bvenneker/AtariXL/README.md

This Chat64 for Atari 800xl  (or 600xl with expanded memory)
