bvenneker/AtariXL/ESP32/800XL_Chat_3/800XL_Chat_3.ino

#include <Preferences.h>
#include <ArduinoJson.h>
#include "common.h"
#include "utils.h"
#include "wifi_core.h"
#include "prgfile.h"
Preferences settings;

// About the regID (registration id)
// A user needs to register at https://www.chat64.nl
// they will receive a registration_id via email.
// that number needs to be filled in on the account setup page on the Atari
// now the cartridge is registered and the administrator has a way to block the user
// the user can not register again with the same email address if they are blocked

// ********************************
// **     Global Variables       **
// ********************************
String urgentMessage = "";
int wificonnected = -1;
char regStatus = 'u';
volatile bool dataFromHost = false;
volatile bool io2 = false;
char inbuffer[250];  // a character buffer for incoming data
int inbuffersize = 0;
char outbuffer[250];  // a character buffer for outgoing data
int outbuffersize = 0;
char textsize = 0;
int it = 0;
int doReset = 0;
volatile byte ch = 0;
TaskHandle_t Task1;
byte send_error = 0;
int userpageCount = 0;
char multiMessageBufferPub[3500];
char multiMessageBufferPriv[3500];
unsigned long first_check = 0;
//int screenColor = 148;
unsigned long hangup =0;
int lastCommand =0;
WiFiCommandMessage commandMessage;
WiFiResponseMessage responseMessage;
bool waitAck = false;
int scrollBufferIndex = 0;
int publicBufferIndex = 0;
int privateBufferIndex =0;
int ackResult=0;
// ********************************
// **        OUTPUTS             **
// ********************************
// see http://www.bartvenneker.nl/index.php?art=0030
// for usable io pins!

#define CLED GPIO_NUM_5     // led on cartridge
#define sclk1 GPIO_NUM_27   // serial clock signal to the shift register
#define RCLK GPIO_NUM_14    // RCLK signal to the 165 shift register
#define sclk2 GPIO_NUM_25   // serial clock signal to the shift register
#define oSdata GPIO_NUM_33  // serial data to output buffer
#define RTR GPIO_NUM_32     // Ready to receive signal
#define RTS GPIO_NUM_4      // Ready to send signal


// ********************************
// **        INPUTS             **
// ********************************
#define resetSwitch GPIO_NUM_26
#define HostIO1 GPIO_NUM_22
#define sdata GPIO_NUM_34
#define HostIO2 GPIO_NUM_13

// *************************************************
// Interrupt routine for IO1
// *************************************************
void IRAM_ATTR isr_io1() {
  // This signal goes LOW when the Atari writes to the $D502 address.
  ready_to_receive(false);
  ch = 0;
  ch = shiftIn(sdata, sclk1, MSBFIRST);
  dataFromHost = true;
}

// *************************************************
// Interrupt routine for IO2
// *************************************************
void IRAM_ATTR isr_io2() {
  // This signal goes LOW when the Atari reads from address $D502
  io2 = true;
}

// *************************************************
// Interrupt routine, to restart the esp32
// *************************************************
void IRAM_ATTR isr_reset() {
  reboot();
}

void resetComputer() {
  // reset the computer.
  // on Atari, there is no reset pin to pull down on the cartridge port
  // instead we try a jump to the start OS vector in $E477
  sendByte(232);
}

void reboot() {
  resetComputer();
  ESP.restart();
}

void create_Task_WifiCore() {
  // we create a task for the second (unused) core of the esp32
  // this task will communicate with the web site while the other core
  // is busy talking to the Host
  xTaskCreatePinnedToCore(
    WifiCoreLoop, /* Function to implement the task */
    "Task1",      /* Name of the task */
    10000,        /* Stack size in words */
    NULL,         /* Task input parameter */
    0,            /* Priority of the task */
    &Task1,       /* Task handle. */
    0);           /* Core where the task should run */
}
// *************************************************
//  SETUP
// *************************************************
void setup() {
    // define inputs
  pinMode(sdata, INPUT);
  pinMode(HostIO1, INPUT_PULLUP);
  pinMode(HostIO2, INPUT_PULLUP);
  pinMode(resetSwitch, INPUT_PULLUP);

  // define interrupts
  attachInterrupt(HostIO1, isr_io1, FALLING);         // interrupt for io1, Atari writes data at $D502
  attachInterrupt(HostIO2, isr_io2, FALLING);         // interrupt for io2, Atari reads data at $D502
  attachInterrupt(resetSwitch, isr_reset, FALLING);  // interrupt for reset button


  // define outputs
  pinMode(RTR, OUTPUT);
  digitalWrite(RTR, LOW);
  pinMode(RTS, OUTPUT);
  digitalWrite(RTS, LOW);

  pinMode(oSdata, OUTPUT);
  pinMode(CLED, OUTPUT);
  digitalWrite(CLED, LOW);
  ready_to_receive(false);
  ready_to_send(false);
  pinMode(RCLK, OUTPUT);
  digitalWrite(RCLK, LOW);  // must be low
  pinMode(sclk1, OUTPUT);
  digitalWrite(sclk1, LOW);  // data shifts to serial data output on the transition from low to high.
  pinMode(sclk2, OUTPUT);
  digitalWrite(sclk2, LOW);  // data shifts to serial data output on the transition from low to high.


  Serial.begin(115200);

  commandBuffer = xMessageBufferCreate(sizeof(commandMessage) + sizeof(size_t));
  responseBuffer = xMessageBufferCreate(sizeof(responseMessage) + sizeof(size_t));

  create_Task_WifiCore();

  // get the wifi mac address, this is used to identify the cartridge.
  commandMessage.command = GetWiFiMacAddressCommand;
  xMessageBufferSend(commandBuffer, &commandMessage, sizeof(commandMessage), portMAX_DELAY);
  xMessageBufferReceive(responseBuffer, &responseMessage, sizeof(responseMessage), portMAX_DELAY);
  macaddress = responseMessage.response.str;
  macaddress.replace(":", "");
  macaddress.toLowerCase();
  macaddress = macaddress.substring(4);

  // add a checksum to the mac address.
  byte data[4];
  int i = 0;
  for (unsigned int t = 0; t < macaddress.length(); t = t + 2) {
    String p = macaddress.substring(t, t + 2);
    char n[3];
    p.toCharArray(n, 3);
    byte f = x2i(n);
    data[i++] = f;
  }
  String crc8 = String(checksum(data, 4), HEX);

  if (crc8.length() == 1) crc8 = "0" + crc8;
  macaddress += crc8;

  // init settings object to store settings in the eeprom
  settings.begin("mysettings", false);
  //
  doReset = settings.getInt("doReset", 0);
  // get the configured status from the eeprom
  configured = settings.getString("configured", "empty");

  // get the registration id from the eeprom
  regID = settings.getString("regID", "unregistered!");

  // get the nick name from the eeprom
  myNickName = settings.getString("myNickName", "empty");

  // get the last known message id (only the private is stored in eeprom)
  lastprivmsg = settings.getULong("lastprivmsg", 1);

  // get Chatserver ip/fqdn from eeprom
  server = settings.getString("server", "www.chat64.nl");
  if (server=="empty") server="www.chat64.nl";
  
  ssid = settings.getString("ssid", "empty");  // get WiFi credentials and Chatserver ip/fqdn from eeprom
  password = settings.getString("password", "empty");
  timeoffset = settings.getString("timeoffset", "+0");  // get the time offset from the eeprom

  screenColor = settings.getUInt("scrcolor", 148);
   
  settings.end();


  //ready_to_receive(false);
  if (doReset != 157) {
    resetComputer();

  } else {
    settings.begin("mysettings", false);
    settings.putInt("doReset", 0);
    messageIds[0] = settings.getULong("lastPubMessage", 0);
    messageIds[1] = settings.getULong("lastPrivMessage", 0);
    settings.end();
    pastMatrix = true;
    hangup=millis();
  }
  settings.begin("mysettings", false);
  settings.putInt("doReset", 0);
  settings.end();




  // load the prg file
  if (!pastMatrix) loadPrgfile();

  // start wifi
  commandMessage.command = WiFiBeginCommand;
  xMessageBufferSend(commandBuffer, &commandMessage, sizeof(commandMessage), portMAX_DELAY);

  //commandMessage.command = GetWiFiLocalIpCommand;
  //xMessageBufferSend(commandBuffer, &commandMessage, sizeof(commandMessage), portMAX_DELAY);
  //xMessageBufferReceive(responseBuffer, &responseMessage, sizeof(responseMessage), portMAX_DELAY);
  //String localIp = responseMessage.response.str;
  // check if we are connected to wifi
  if (isWifiCoreConnected) {
    wificonnected = 1;
  }
  pmCount=0;
}  // end of setup

// ******************************************************************************
// Main loop
// ******************************************************************************
int pos1 = 0;
int pos0 = 0;
bool wifiError = false;
void loop() {


  digitalWrite(CLED, isWifiCoreConnected);
  ready_to_receive(true);

  if (isWifiCoreConnected and wificonnected == -1) wificonnected = 1;  // only set wificonnected if it has not been set

  if (dataFromHost) {
    dataFromHost = false;
    ready_to_receive(false);  // flow controll
    lastCommand=ch;
#ifdef debug
    //Serial.printf("incoming command: %d\n", lastCommand);
#endif

    //
    if (wifiError and isWifiCoreConnected) {
      urgentMessage = "Wifi connection restored.       ";
      wifiError = false;
      wificonnected = 1;
    }

    // generate an error if wifi connection drops
    if (wificonnected == 1 && !isWifiCoreConnected) {
      digitalWrite(CLED, LOW);
      wificonnected = 0;
      myLocalIp = "0.0.0.0";
      urgentMessage = "Error in WiFi connection.       ";
      wifiError = true;
    }

    // 254 = Computer triggers call to the website for new public message
    // 253 = New chat message from Computer to database
    // 252 = Computer sends the new wifi network name (ssid) AND password AND time offset
    // 251 = Computer ask for the current wifi ssid,password and time offset
    // 250 = Computer ask for the first full page of messages (during startup)
    // 249 = get result of last send action (253)
    // 248 = Computer ask for the wifi connection status
    // 247 = Computer triggers call to the website for new private message
    // 246 = set chatserver ip/fqdn
    // 245 = check if the esp is connected at all, or are we running in simulation mode?
    // 244 = reset to factory defaults
    // 243 = Computer ask for the mac address, registration id, nickname and regstatus
    // 242 = get senders nickname of last private message.
    // 241 = get the number of unread private messages
    // 240 = Computer sends the new registration id and nickname to ESP32
    // 239 = Computer asks if updated firmware is available
    // 238 = Computer triggers call to the chatserver to test connectivity
    // 237 = get chatserver connectivity status
    // 236 = Computer asks for the server configuration status and servername
    // 235 = Computer sends server configuration status
    // 234 = get user list first page
    // 233 = get user list next page
    // 232 = Restart the computer (Atari only)
    // 231 = Do the update
    // 230 = Computer sends screen color (Atari Only)
    // 228 = NACK, Not Acknowledge message!
    // 227 = ACK, Acknowledge message!
    // 128 = end marker, ignore

    switch (ch) {
      case 254:
        {
          hangup = millis();
          // ------------------------------------------------------------------------------
          // start byte 254 = Computer triggers call to the website for new public message
          // ------------------------------------------------------------------------------
          if (first_check == 0) first_check = millis();
          pastMatrix=true;
          // send urgent messages first
          doUrgentMessage();
          // if the user list is empty, get the list
          // also refresh the userlist when we switch from public to private messaging and vice versa
          if (onLineUsers.length() < 1 or msgtype != "public") updateUserlist = true;
          msgtype = "public";
          if (getMessageFromMMBuffer(multiMessageBufferPub, &publicBufferIndex, false)) {
            if (Deserialize() == 1) {              
              // deserialize returns 1 of there was a message in the buffer (2 for private message).
              translateAtariMessage();
              //prependChecksum(outbuffer, &outbuffersize); // add a checksum to the end of the buffer
              send_buffer_to_host(outbuffer, outbuffersize);  // send it
              messageIds[0] = tempMessageIds[0];             // store the new message id;
            } else sendByte(128);                            // no more messages for now.              
          } else {
            sendByte(128);  // no more messages for now.
            getMessage = true;
          }
          break;
        }

      case 253:
        {
          // ------------------------------------------------------------------------------
          // start byte 253 = new chat message from Computer to database
          // ------------------------------------------------------------------------------
          // we expect a chat message from the Computer
          
          receive_buffer_from_host(1,true);

          String toEncode = "[145]";
          String RecipientName = "";
          int pmuserlen=0;          
          int mstart = 0;

          // Get the RecipientName
          // see if the message starts with '@'
          byte b = inbuffer[0];
          if (b == '@') {
            for (int x = 1; x < 15; x++) {
              byte b = inbuffer[x];
              if (b != ' ' and b != ',' and b != ':' and b != ';' and b != '.') {
                if (b < 127) {
                  RecipientName = (RecipientName + char(b));
                }
              } else {
                mstart = x + 1;
                toEncode = toEncode + "@" + RecipientName + " ";
                break;
              }
            }
          }

          for (int x = mstart; x < inbuffersize - 1; x++) {
            byte b = inbuffer[x];
            toEncode = (toEncode + inbuffer[x]);
          }

          if (RecipientName != "") {
            // is this a valid username?
            String test_name = RecipientName;
            if (test_name.endsWith(",") or test_name.endsWith(".")) {
              test_name.remove(test_name.length() - 1);
            }
            test_name.toLowerCase();
#ifdef debug
            Serial.print("known users: ");
            Serial.println(users);
            Serial.print("Name under test: ");
            Serial.println(test_name);
#endif
            if ((offLineUsers.indexOf(test_name + ';') >= 0) or (onLineUsers.indexOf(test_name + ';') >= 0)) {
              // user exists
              msgtype = "private";
              pmSender = '@' + RecipientName;
            } else {
              // user does not exist
#ifdef debug
              Serial.println("Username not found in list");
#endif
              urgentMessage = "Error: Unknown user:" + RecipientName;
              send_error = 1;
              break;
            }
          } else {
            msgtype = "public";
          }
          toEncode.trim();

          int buflen = toEncode.length() + 1;
          if (buflen -mstart <= 7) break;                  // this is an empty message! do not send it.
          char buff[buflen];
          toEncode.toCharArray(buff, buflen);
          String Encoded = my_base64_encode(buff, buflen);
          Encoded = urlEncode(Encoded);
          // Now send it with retry!
          bool sc = false;
          int retry = 0;
          while (sc == false and retry < 2) {
            sendingMessage = 1;
            commandMessage.command = SendMessageToServerCommand;
            Encoded.toCharArray(commandMessage.data.sendMessageToServer.encoded, sizeof(commandMessage.data.sendMessageToServer.encoded));
            RecipientName.toCharArray(commandMessage.data.sendMessageToServer.recipientName, sizeof(commandMessage.data.sendMessageToServer.recipientName));
            commandMessage.data.sendMessageToServer.retryCount = retry;
            xMessageBufferSend(commandBuffer, &commandMessage, sizeof(commandMessage), portMAX_DELAY);
            xMessageBufferReceive(responseBuffer, &responseMessage, sizeof(responseMessage), portMAX_DELAY);
            sc = responseMessage.response.boolean;
            // sending the message fails, take a short break and try again
            if (!sc) {
              delay(1000);
              retry = retry + 1;
            }
          }
          // if it still fails after a few retries, give us an error.
          if (!sc) {
            urgentMessage = ">>ERROR: sending the message<<";
            send_error = 1;
            sendingMessage = 0;
          } else {
            // No error, read the message back from the database to show it on screen
            sendingMessage = 0;
            getMessage = true;  // get the message we just inserted
          }
          break;
        }

      case 252:
        {
          // ------------------------------------------------------------------------------
          // 252 = Computer sends the new wifi network name (ssid) AND password AND time offset
          // ------------------------------------------------------------------------------

          receive_buffer_from_host(3,true);
          // inbuffer now contains "SSID password timeoffset"
          char bns[inbuffersize + 1];
          strncpy(bns, inbuffer, inbuffersize + 1);
          String ns = bns;

          ssid = getValue(ns, 129, 0);
          ssid = ssid.substring(0,27);
          
          ssid.trim();
          Serial.print("SSID=");
          Serial.println(ssid);
          password = getValue(ns, 129, 1);
          password=password.substring(0,23);
          password.trim();
          Serial.print("PASW=");
          Serial.println(password);
          timeoffset = getValue(ns, 129, 2);
          timeoffset = timeoffset.substring(0,5);
          timeoffset.trim();
          Serial.print("GMT+=");
          Serial.println(timeoffset);

          settings.begin("mysettings", false);
          settings.putString("ssid", ssid);
          settings.putString("password", password);
          settings.putString("timeoffset", timeoffset);
          settings.end();
          softReset();
          break;
        }

      case 251:
        {
          // ------------------------------------------------------------------------------
          // start byte 251 = Computer ask for the current wifi ssid,password and time offset
          // ------------------------------------------------------------------------------
          send_String_to_host(ssid + char(129) + password + char(129) + timeoffset);
          break;
        }

      case 249:
        {
          // ------------------------------------------------------------------------------
          // start byte 249 = Computer asks if this is an existing user (for private chat)
          // ------------------------------------------------------------------------------
          sendByte(send_error);
          sendByte(128);
          send_error = 0;
          break;
        }

      case 248:
        {
          // ------------------------------------------------------------------------------
          // start byte 248 = Computer ask for the wifi connection status
          // ------------------------------------------------------------------------------

          if (!isWifiCoreConnected) {
            digitalWrite(CLED, LOW);
            send_String_to_host("0    Not Connected to Wifi         ");
          } else {
            wificonnected = 1;
            digitalWrite(CLED, HIGH);
            String wifi_status = "1Connected, ip: " + myLocalIp + "             ";
            wifi_status = wifi_status.substring(0, 35);
            send_String_to_host(wifi_status);
            if (configured == "empty") {
              configured = "w";
              settings.begin("mysettings", false);
              settings.putString("configured", "w");
              settings.end();
            }
          }
          break;
        }

      case 247:
        {
          hangup = millis();
          // ------------------------------------------------------------------------------
          // start byte 247 = Computer triggers call to the website for new private message
          // ------------------------------------------------------------------------------
          // send urgent messages first
          doUrgentMessage();
          // if the user list is empty, get the list
          // also refresh the userlist when we switch from public to private messaging and vice versa
          if (onLineUsers.length() < 1 or msgtype != "private") updateUserlist = true;
          msgtype = "private";
          if (getMessageFromMMBuffer(multiMessageBufferPriv, &privateBufferIndex, false)) {
            if (Deserialize() == 2) {              
              // deserialize returns 2 of there was a message in the buffer (1 for public message).
              translateAtariMessage();
              send_buffer_to_host(outbuffer, outbuffersize);  // send it
              messageIds[1] = tempMessageIds[1];             // store the new message id;
              lastprivmsg = messageIds[1];
              settings.begin("mysettings", false);
              settings.putULong("lastprivmsg", messageIds[1]);  // store message id in eeprom
              settings.end();
            } else sendByte(128);                            // no more messages for now.              
          } else {
            sendByte(128);  // no more messages for now.
            getMessage = true;
          }
          break;
        }

      case 246:
        {
          // ------------------------------------------------------------------------------
          // start byte 246 = Computer sends a new chat server ip/fqdn
          // ------------------------------------------------------------------------------

          receive_buffer_from_host(1,true);

          char bns[inbuffersize + 1];
          strncpy(bns, inbuffer, inbuffersize + 1);
          String ns = bns;

          ns.remove(ns.length() - 1);
          ns.trim();
          server = ns;
          settings.begin("mysettings", false);
          settings.putString("server", ns);  // store the new server name in the eeprom settings
          settings.end();
          messageIds[0] = 0;
          messageIds[1] = 0;

          // we should also refresh the userlist
          onLineUsers = "";
          break;
        }
      case 245:
        {
          // -----------------------------------------------------------------------------------------------------
          // start byte 245 = Computer checks if the Cartridge is connected at all.. or are we running in a simulator?
          // -----------------------------------------------------------------------------------------------------
          // receive the ROM version number

          receive_buffer_from_host(1,true);
          char bns[inbuffersize + 1];
          // filter out any unwanted bytes, keep only ./01234567890
          for (int k = 0; k < inbuffersize; k++) {
            inbuffer[k] = inbuffer[k] - 32;  // translate to atari screen coding
            if (inbuffer[k] < 45 or inbuffer[k] > 57) inbuffer[k] = 32;
          }
          strncpy(bns, inbuffer, inbuffersize + 1);
          String ns = bns;
          ns.replace(" ", "");
          romVersion = ns;
          // respond with byte 128 to tell the computer the cartridge is present
          sendByte(128);
          pastMatrix = true;
          getMessage = true;
#ifdef debug
          Serial.print("ROM Version=");
          Serial.println(romVersion);
          Serial.println("are we in the Matrix?");
#endif
          break;
        }
      case 244:
        {
          // ---------------------------------------------------------------------------------
          // start byte 244 = Computer sends the command to reset the cartridge to factory defaults
          // ---------------------------------------------------------------------------------
          // this will reset all settings

          receive_buffer_from_host(1,true);
          char bns[inbuffersize + 1];
          strncpy(bns, inbuffer, inbuffersize + 1);
          String ns = bns;
          if (ns.startsWith("RESET!")) {
            settings.begin("mysettings", false);
            settings.putString("regID", "unregistered!");
            settings.putString("myNickName", "empty");
            settings.putString("ssid", "empty");
            settings.putString("password", "empty");
            settings.putString("server", "www.chat64.nl");
            settings.putString("configured", "empty");
            settings.putString("timeoffset", "+0");
            settings.putUInt("scrcolor", 148);
            settings.end();
            // now reset the esp
            reboot();
          }
          break;
        }

      case 243:
        {
          // ------------------------------------------------------------------------------
          // start byte 243 = Computer ask for the mac address, registration id, nickname and regstatus
          // ------------------------------------------------------------------------------
          commandMessage.command = GetRegistrationStatusCommand;
          xMessageBufferSend(commandBuffer, &commandMessage, sizeof(commandMessage), portMAX_DELAY);
          xMessageBufferReceive(responseBuffer, &responseMessage, sizeof(responseMessage), portMAX_DELAY);
          regStatus = responseMessage.response.str[0];

          send_String_to_host(macaddress + char(129) + regID + char(129) + myNickName + char(129) + regStatus + char(128));
          if (regStatus == 'r' and configured == "w") {
            configured = "d";
            settings.begin("mysettings", false);
            settings.putString("configured", "d");
            settings.end();
          }
          break;
        }
      case 242:
        {
          // ------------------------------------------------------------------------------
          // start byte 242 = Computer ask for the sender of the last private message
          // ------------------------------------------------------------------------------
          send_String_to_host(pmSender);
          break;
        }
      case 241:
        {
          // ------------------------------------------------------------------------------
          // start byte 241 = Computer asks for the number of unread private messages
          // ------------------------------------------------------------------------------
          if (pmCount > 10) pmCount = 10;
          String pm = String(pmCount);
          if (pmCount < 10) { pm = "0" + pm; }
          pm = "[PM:" + pm + "]";
          if (pmCount == 0) pm = "--";
          //Serial.println(pm);
          send_String_to_host(pm);  // then send the number of messages as a string
          break;
        }
      case 240:
        {
          // ------------------------------------------------------------------------------
          // start byte 240 = Computer sends the new registration id and nickname to ESP32
          // ------------------------------------------------------------------------------
          receive_buffer_from_host(2,true);
          // inbuffer now contains "registrationid nickname"
          char bns[inbuffersize + 1];
          strncpy(bns, inbuffer, inbuffersize + 1);
          String ns = bns;

          regID = getValue(ns, 129, 0);
          regID=regID.substring(0,16);
          regID.trim();
          
#ifdef debug
          Serial.println(regID);
#endif
          if (regID.length() != 16) {
#ifdef debug
            Serial.println("Registration code length should be 16");
#endif
            break;
          }
          myNickName = getValue(ns, 129, 1);
          myNickName = myNickName.substring(0,10);
          myNickName.trim();
          myNickName.replace(' ', '_');
#ifdef debug
          Serial.println(myNickName);
#endif

          settings.begin("mysettings", false);
          settings.putString("regID", regID);
          settings.putString("myNickName", myNickName);
          settings.end();
          break;
        }
      case 239:
        {
          // ------------------------------------------------------------------------------
          // start byte 239 = Computer asks if updated firmware is available
          // ------------------------------------------------------------------------------                  
          send_String_to_host(newVersions);
          if (newVersions != "") urgentMessage = "New version available, press [ESC]";
          break;
        }
      case 238:
        {
          // ------------------------------------------------------------------------------
          // start byte 238 = Computer triggers call to the chatserver to test connectivity
          // ------------------------------------------------------------------------------
          ServerConnectResult = "Connection: Unknown, try again";
          commandMessage.command = ConnectivityCheckCommand;
          xMessageBufferSend(commandBuffer, &commandMessage, sizeof(commandMessage), portMAX_DELAY);          
          break;
        }
      case 237:
        {
          // ------------------------------------------------------------------------------
          // start byte 237 = Computer triggers call to receive connection status
          // ------------------------------------------------------------------------------
          send_String_to_host(ServerConnectResult);
          break;
        }
      case 236:
        {
          // ------------------------------------------------------------------------------
          // start byte 236 = Computer asks for the server configuration status and servername
          // ------------------------------------------------------------------------------
#ifdef debug
          Serial.println("response 236 = " + configured + " " + server + " " + SwVersion);
#endif
          send_String_to_host(configured + char(129) + server + char(129) + SwVersion + char(129));
          break;
        }
      case 235:
        {
          // ------------------------------------------------------------------------------
          // start byte 235 = Computer sends configuration status
          // ------------------------------------------------------------------------------
          receive_buffer_from_host(1,true);
          char bns[inbuffersize + 1];
          strncpy(bns, inbuffer, inbuffersize + 1);
          String ns = bns;
          configured = ns;
          settings.begin("mysettings", false);
          settings.putString("configured", ns);
          settings.end();
          break;
        }
      case 234:
        {
          // Computer asks for user list, first group.
          // we send a max of 20 users in one long string
          userpageCount = 0;
          String ul1 = userPages[userpageCount];
          send_String_to_host(ul1);
          userpageCount++;
          break;
        }
      case 233:
        {
          // Computer asks for user list, second or third group.
          // we send a max of 20 users in one long string
          String ul1 = userPages[userpageCount];
          send_String_to_host(ul1);
          userpageCount++;
          break;
        }
      case 232:
        {
          Serial.println("RESET button on Atari pressed");
          ESP.restart();
          break;
        }
      case 231:
        {  // do the update!
          receive_buffer_from_host(1,true);
          char bns[inbuffersize + 1];
          strncpy(bns, inbuffer, inbuffersize + 1);
          String ns = bns;          
          if (ns.startsWith("UPDATE!")) {
            Serial.println("Update = GO <<<<");
            outByte(2);
            detachInterrupt(HostIO1);  // disable IO1 and IO2 interrupts
            detachInterrupt(HostIO2);  // disable IO1 and IO2 interrupts
            commandMessage.command = DoUpdateCommand;
            xMessageBufferSend(commandBuffer, &commandMessage, sizeof(commandMessage), portMAX_DELAY);
          }
          break;
        }
      case 230:
        {
          dataFromHost=false;
          ready_to_receive(true);          
          while (dataFromHost == false) {
            delayMicroseconds(2);
          }
          ready_to_receive(false);
          screenColor = ch;
          dataFromHost=false;
          settings.begin("mysettings", false);
          settings.putUInt("scrcolor", screenColor);
          settings.end();
          break;
        }
      case 229:
        {
          // ------------------------------------------------------------------------------
          // start byte 229 = Scroll Up or Down
          // ------------------------------------------------------------------------------
          static String decoded_message;
          receive_buffer_from_host(1,false);
          if (inbuffer[0] == 0) topMes = 0;
          Serial.print("topMes=");
          Serial.println(topMes);
          systemLineCount = inbuffer[1];
          Serial.print("systemLineCount=");
          Serial.println(systemLineCount);
          pageSize = inbuffer[2];
          scrollDirection = inbuffer[3];  // 1 = up, 0 = down
          Serial.println("Scrolling starts");
          if (waitAck) {
            // if waitAck is true we repeat the message
            Serial.println("Waiting for ACK, resending last message");
            send_String_to_host(decoded_message);
            break;
          }
          
          if (scrollBufferIndex == 0) {  // send a message to the other core to collect older messages            
            gotScrollMessage = 0;
            commandMessage.command = ScrollUpDown;
            xMessageBufferSend(commandBuffer, &commandMessage, sizeof(commandMessage), portMAX_DELAY);
            while (gotScrollMessage == 0) delay(10);  // wait for that procedure to complete
          }
          // (more) data is in multiMessageBufferPub, collect a single message from the MMB
          if (getMessageFromMMBuffer(multiMessageBufferPub, &scrollBufferIndex, false)) {            
            if (Deserialize() == 3) {  // decoded message is in the msgbuffer now
              if (scrollDirection == 1) topMes = tempMessageIds[2];              
              if (scrollDirection == 0) botMes = tempMessageIds[2];
              Serial.print("topMes(2)=");
              Serial.println(topMes);
              Serial.println("Wait for ACK now");
              waitAck = true;
              // message is in the msgbuffer now.
              // invert the first 40 chars.
              for (int i=1;i<41;i++){
                 msgbuffer[i]=msgbuffer[i]+128;
              }
              //msgbuffer[msgbuffersize-1]=128;
              decoded_message = String(msgbuffer, msgbuffersize-1);
              //Serial.println((int)decoded_message[msgbuffersize-2]);
              //Serial.println((int)decoded_message[msgbuffersize-1]);
              Serial.print("lines=");
              Serial.println((int)decoded_message[0]);
              Serial.println(decoded_message);
              send_String_to_host(decoded_message);
              //send_buffer_to_host(msgbuffer, msgbuffersize);  // send it
              if (scrollDirection == 1 and topMes != 0) botMes = 0;
              break;
            }
          }
          sendByte(128);
          waitAck = false;
          break;
        } 
      case 228:
        { // NACK, negative acknowlegde. Something went wrong, the Computer needs the same message again.
          waitAck = false;
          ackResult=0;
          Serial.println("NOT ACK!");
          break; 
        }   
      case 227:
        { // ACK, message was received without error. Computer is ready for the next message.
          waitAck = false;
          ackResult=1;
          Serial.println("ACK!");
          break; 
        }  
      default:
        {
          sendByte(128);
          break;
        }
    }  // end of case statements


  }  // end of "if (dataFromHost)"
  else {
    if ((lastCommand==247 or lastCommand==254 or lastCommand==239 or lastCommand==241) and (millis() - hangup) > 2000){
       hangup=millis();
       sendByte(128);
       Serial.print("Prevented hangup with command: ");
       Serial.println(lastCommand);
    }
    // No data from host
  }
}  // end of main loop


// ******************************************************************************
// void to set a byte in the 74ls595 shift register
// ******************************************************************************
void outByte(byte c) {
  digitalWrite(RCLK, LOW);
  shiftOut(oSdata, sclk2, MSBFIRST, c);
  digitalWrite(RCLK, HIGH);
}

// ******************************************************************************
// void: send a string to the Computer
// ******************************************************************************
void send_String_to_host(String s) {
  outbuffersize = s.length() + 1;              // set outbuffer size
  s.toCharArray(outbuffer, outbuffersize);     // place the ssid in the output buffer
  send_buffer_to_host(outbuffer,outbuffersize); // and send the buffer
}

// ******************************************************************************
// Send the content of the outbuffer to the host
// ******************************************************************************
void send_buffer_to_host(char *buffer, int buffSize) {
  int lastbyte;
  // send the content of a buffer to the Atari
  for (int x = 0; x < buffSize - 1; x++) {
    delayMicroseconds(500);
    sendByte(buffer[x]);
    lastbyte = outbuffer[x];
  }
  if (lastbyte != 128) {  // all done, send end byte if not send yet
    delayMicroseconds(500);
    sendByte(128);
  }
}

// ******************************************************************************
// void: for debugging
// ******************************************************************************
void debug_print_inbuffer() {
  for (int x = 0; x < inbuffersize; x++) {
    char sw = screenCode_to_Ascii(inbuffer[x]);
    Serial.print(sw);
  }
}

// ******************************************************************************
//  void to receive characters from the host and store them in a buffer
// ******************************************************************************
void receive_buffer_from_host(int cnt,bool translate) {

  // cnt is the number of transmissions we put into this buffer
  // This number is 1 most of the time
  // but in the configuration screens the Computer will send multiple items at once (like ssid and password)

  int i = 0;
  while (cnt > 0) {
    ready_to_receive(true);  // ready for next byte
    unsigned long timeOut = millis() + 50;

    while (dataFromHost == false) {
      delayMicroseconds(2);  // wait for next byte
      if (millis() > timeOut) {
        ch = 128;
        dataFromHost = true;
#ifdef debug
        Serial.println("Timeout in receive buffer");
#endif
      }
    }
    ready_to_receive(false);
    dataFromHost = false;
    if (translate) 
      inbuffer[i] = Atari_to_Ascii(ch);
    else
      inbuffer[i] = ch;

    //Serial.print(inbuffer[i]);
    i++;
    if (i > 248) {  //this should never happen
#ifdef debug
      Serial.println("Error: inbuffer is about to flow over!");
#endif
      ch = 128;
      cnt = 1;
      break;
    }
    if (ch == 128) {
      cnt--;
      inbuffer[i] = 129;
      i++;
      //Serial.println();
    }
  }
  i--;
  inbuffer[i] = 0;  // close the buffer
  inbuffersize = i;
}

// ******************************************************************************
// send a single byte to the Host
// ******************************************************************************
bool sendByte(byte b) {
  bool result=true;

  outByte(b);
  io2 = false;
  ready_to_send(true);
  // wait for io2 interupt
  unsigned long timeOut = millis() + 300;
  while (io2 == false) {
    delayMicroseconds(2);
    if (millis() > timeOut) {
      io2 = true;
      Serial.print("Timeout in sendByte: ");
      Serial.println(b);
      result=false;
    }
  }
  ready_to_send(false);
  io2 = false;
  return result;
}

// ******************************************************************************
// Send out urgent message if available (error messages)
// ******************************************************************************
void doUrgentMessage() {
  int color = 2;
  if (urgentMessage != "") {
    urgentMessage = " " + urgentMessage;

    outbuffersize = urgentMessage.length() + 1;
    urgentMessage.toCharArray(outbuffer, outbuffersize);
    outbuffer[0] = 1;

    for (int x = 1; x < outbuffersize; x++) {
      int b = outbuffer[x] + 128;  // add 128 to inverse the text
      if (b < 97) b = b - 32;
      if (b >= 160 and b < 192) b = b - 32;
      else if (b > 191 and b < 225) b = b - 32;
      if (b == 128) b = 254;
      outbuffer[x] = b;
    }

    send_buffer_to_host(outbuffer,outbuffersize);
    urgentMessage = "";
  }
}

void translateAtariMessage() {
  // do some translations for Atari 800 XL
  // first byte is number of lines.
  // for the atari we start with a number of 'shift up commands' 
  int sp = msgbuffer[0];
  outbuffersize = 0;
  for (int a = 0; a < sp; a++) {
    outbuffer[a] = 1;  // 1 means shift up one line.  1,1,1 means shift up 3 lines
  }
  outbuffersize = sp;
  // now convert to internal codes (screen codes)
  for (int x = 1; x < msgbuffersize; x++) {
    int b = msgbuffer[x];
    if (b < 97) b = b - 32;
    if (b >= 160 and b < 192) b = b - 32;
    else if (b > 191 and b < 225) b = b - 32;
    if (b == 128) b = 254;
    outbuffer[outbuffersize] = b;
    outbuffersize++;
  }
}

void ready_to_receive(bool b) {  
  if (b) {
    digitalWrite(RTR, HIGH);    
  }
  else {
    digitalWrite(RTR, LOW);
  }
  return;
}

void ready_to_send(bool b) {
  if (b){
    digitalWrite(RTS, HIGH);
  }
  else {
    digitalWrite(RTS, LOW);
  }
  return;
}

uint8_t myShiftIn(uint8_t dataPin, uint8_t clockPin, uint8_t bitOrder) {
  uint8_t value = 0;
  uint8_t i;

  for (i = 0; i < 8; ++i) {
    digitalWrite(clockPin, HIGH);
    delayMicroseconds(5);
    //if (bitOrder == LSBFIRST)
    //    value |= digitalRead(dataPin) << i;
    //else
    value |= digitalRead(dataPin) << (7 - i);
    digitalWrite(clockPin, LOW);
  }
  return value;
}


void myShiftOut(uint8_t dataPin, uint8_t clockPin, uint8_t bitOrder, uint8_t val) {
  uint8_t i;

  digitalWrite(clockPin, LOW);

  for (i = 0; i < 8; i++) {
    if (bitOrder == LSBFIRST) {
      digitalWrite(dataPin, val & 1);
      val >>= 1;
    } else {
      digitalWrite(dataPin, (val & 128) != 0);
      val <<= 1;
    }

    delayMicroseconds(10);
    digitalWrite(clockPin, HIGH);
    delayMicroseconds(10);
    digitalWrite(clockPin, LOW);
  }
}

// Compute -bit additive checksum and prepend it to the buffer
void prependChecksum(char *buffer, int *bufferSize) {
    uint8_t sum = 0;

    // Compute 8-bit additive checksum
    for (int i = 0; i < *bufferSize; i++) {
        sum += buffer[i];  // uint8_t overflow is automatic
    }

    // Move the data forward by 1 byte to make room for checksum
    memmove(buffer + 1, buffer, *bufferSize);

    // Store checksum at the start
    buffer[0] = sum;

    // Update buffer size
    (*bufferSize)++;
}

String urlEncode(const String &s)
{
    String out;
    char hex[4];

    for (size_t i = 0; i < s.length(); i++) {
        char c = s[i];
        if (isalnum(c) || c == '-' || c == '_' || c == '.' || c == '~') {
            out += c;
        } else {
            sprintf(hex, "%%%02X", (unsigned char)c);
            out += hex;
        }
    }
    return out;
}
