bvenneker/AtariXL/ESP32/800XL_Chat_3/prgfile.h

// array size is 12618. 2025-12-26 18:23
// version in ROM = 3.88, date in ROM = 11/2025
static const byte prgfile[] PROGMEM  = {
0xff,0xff,0x00,0x20,0x3d,0x51,0xa9,0x00,0x85,0x52,0x18,0xa5,0x58,0x69,0x48,0x85,
0x43,0x18,0xa5,0x59,0x69,0x03,0x85,0x44,0xa9,0x00,0x85,0x3f,0x8d,0x59,0x4f,0x8d,
0x5a,0x4f,0x8d,0xdd,0x50,0x8d,0xdc,0x50,0x8d,0x5b,0x4f,0x8d,0x64,0x4f,0x8d,0x65,
0x4f,0xa5,0x58,0x85,0x15,0xa5,0x59,0x85,0x16,0xa9,0xaa,0x8d,0xde,0x50,0xa5,0x58,
0x85,0x17,0x8d,0x08,0x51,0xa5,0x59,0x85,0x18,0x8d,0x23,0x51,0xa2,0x01,0x18,0xa5,
0x17,0x69,0x28,0x9d,0x08,0x51,0x85,0x17,0xb0,0x0a,0xa5,0x18,0x9d,0x23,0x51,0x85,
0x18,0x4c,0x67,0x20,0xa4,0x18,0xc8,0x98,0x9d,0x23,0x51,0x84,0x18,0xe8,0xe0,0x16,
0xd0,0xdc,0x20,0x85,0x35,0x20,0x0b,0x3e,0x20,0x6b,0x40,0x20,0x57,0x42,0x20,0x05,
0x2a,0x20,0xf6,0x23,0xad,0x69,0x4f,0xc9,0x64,0xd0,0x03,0x4c,0x33,0x21,0x4c,0x03,
0x25,0xad,0x65,0x4f,0xc9,0x03,0xf0,0x01,0x60,0xa5,0x43,0x85,0x17,0xa5,0x44,0x85,
0x18,0xa0,0x00,0x84,0x55,0xa9,0x1c,0x20,0x4c,0x40,0xb9,0xa1,0x4f,0xc9,0x80,0xf0,
0x08,0x91,0x17,0xc8,0xe6,0x55,0x4c,0xa4,0x20,0xa9,0x1d,0x20,0x4c,0x40,0xa9,0x20,
0xa0,0x00,0x91,0x17,0xa9,0x20,0x20,0x4c,0x40,0x60,0x20,0x5c,0x22,0x20,0x8c,0x3b,
0xad,0x65,0x4f,0xc9,0x03,0xd0,0x03,0x4c,0x33,0x21,0xa9,0x03,0x8d,0x65,0x4f,0x4c,
0xea,0x22,0x20,0x05,0x2a,0xa9,0x00,0x85,0x54,0xa9,0x00,0x85,0x55,0xa9,0x00,0x85,
0x3f,0xa9,0x28,0x85,0x83,0xa9,0xdd,0x85,0x40,0xa9,0x4c,0x85,0x41,0x20,0xfe,0x3f,
0xa9,0x01,0x85,0x54,0xa9,0x00,0x85,0x55,0xa9,0x00,0x85,0x3f,0xa9,0x26,0x85,0x83,
0xa9,0x5c,0x85,0x40,0xa9,0x45,0x85,0x41,0x20,0xfe,0x3f,0xa9,0x02,0x85,0x54,0xa9,
0x00,0x85,0x55,0xa9,0x00,0x85,0x3f,0xa9,0x28,0x85,0x83,0xa9,0xdd,0x85,0x40,0xa9,
0x4c,0x85,0x41,0x20,0xfe,0x3f,0x4c,0x3e,0x21,0xa9,0x00,0x8d,0x65,0x4f,0x4c,0xea,
0x22,0x20,0x05,0x2a,0xad,0x68,0x4f,0xc9,0x01,0xf0,0x03,0x4c,0x6e,0x21,0xa9,0x94,
0x8d,0xc8,0x02,0x8d,0xc6,0x02,0x20,0xd8,0x3b,0xa9,0x05,0x85,0x54,0xa9,0x06,0x85,
0x55,0xa9,0x00,0x85,0x3f,0xa9,0x18,0x85,0x83,0xa9,0x82,0x85,0x40,0xa9,0x45,0x85,
0x41,0x20,0xfe,0x3f,0xa9,0xff,0x8d,0xfc,0x02,0xa9,0x00,0x85,0x55,0xa9,0x14,0x85,
0x54,0xa9,0x00,0x85,0x55,0xa9,0x00,0x85,0x3f,0xa9,0x28,0x85,0x83,0xa9,0xdd,0x85,
0x40,0xa9,0x4c,0x85,0x41,0x20,0xfe,0x3f,0x20,0x52,0x3c,0x20,0x6b,0x40,0x20,0x9a,
0x23,0x20,0x73,0x40,0x20,0x8b,0x20,0x4c,0xbb,0x37,0x78,0xa2,0x12,0xbd,0x08,0x51,
0x85,0x17,0xbd,0x23,0x51,0x85,0x18,0xe8,0xbd,0x08,0x51,0x85,0x19,0xbd,0x23,0x51,
0xca,0x85,0x1a,0xa0,0x27,0xb1,0x17,0x91,0x19,0x88,0xc0,0xff,0xd0,0xf7,0xca,0xe0,
0xff,0xd0,0xda,0xad,0x08,0x51,0x85,0x17,0xad,0x23,0x51,0x85,0x18,0xa0,0x27,0xa9,
0x00,0x91,0x17,0x88,0xc0,0xff,0xd0,0xf9,0x58,0x60,0x78,0xad,0x65,0x4f,0xc9,0x03,
0xd0,0x21,0xa2,0x10,0xa5,0x58,0x85,0x17,0xa5,0x59,0x85,0x18,0xa5,0x58,0x85,0x19,
0xa5,0x59,0x85,0x1a,0xa5,0x17,0x69,0x78,0x85,0x17,0xa5,0x19,0x69,0xa0,0x85,0x19,
0x4c,0x2d,0x22,0xa2,0x13,0xa5,0x58,0x85,0x17,0xa5,0x59,0x85,0x18,0xa5,0x58,0x85,
0x19,0xa5,0x59,0x85,0x1a,0x18,0xa5,0x19,0x69,0x28,0x85,0x19,0xb0,0x03,0x4c,0x2d,
0x22,0xe6,0x1a,0x20,0x4f,0x22,0xa5,0x19,0x85,0x17,0xa5,0x1a,0x85,0x18,0xca,0xd0,
0xe4,0xad,0x9f,0x4f,0x85,0x17,0xad,0xa0,0x4f,0x85,0x18,0xa0,0x27,0xa9,0x00,0x91,
0x17,0x88,0xd0,0xfb,0x60,0xa0,0x00,0xb1,0x19,0x91,0x17,0xc8,0xc0,0x28,0xd0,0xf7,
0x58,0x60,0xa5,0x54,0x8d,0x93,0x4f,0x20,0x8b,0x23,0xad,0x64,0x4f,0xc9,0x00,0xf0,
0x01,0x60,0xad,0x65,0x4f,0xc9,0x03,0xf0,0x04,0x4c,0x93,0x22,0x60,0xa5,0x55,0x8d,
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
};
