bvenneker/AtariXL/ASM/Chat800XL_v3_0.asm

// special characters: https://www.youtube.com/watch?v=fOrMwNBoC7E&list=PLmzSn5Wy9uF8nTsZBtdk1yHzFI5JXoUJT&index=7
                                                  // 
// https://www.atarimax.com/jindroush.atari.org/acarts.html
// https://atariwiki.org/wiki/Wiki.jsp?page=CartridgesexitVersions
// https://grandideastudio.com/media/pp_atari8bit_instructions.pdf
// https://grandideastudio.com/media/pp_atari8bit_schematic.pdf
                                                  //
                                                  // 
putchar_ptr = $346                                // pointer to print routine
                                                  // 
WSYNC     = $d40a                                 // 
NMIEN     = $d40e                                 // 
VDSLST    = $0200                                 // 
COLPF0    = $d016                                 // 
NMIEN_DLI = $80                                   // 
NMIEN_VBI = $40                                   // 
COLPF1    = $d017                                 // 
COLPF2    = $d018                                 // 
COLPF3    = $d019                                 // 
COLOR0    = $02c4                                 // 
SDLSTL    = $0230                                 // 
CHARSET   = $2F4                                  // 
ROM_CHARS = $E000                                 // 
POKEY     = $D200                                 // 
                                                  // 
COLOR2 = $2c6                                     // 
COLOR4 = $2c8                                     // 
                                                  // 
TEXTBOX = $15                                     // input field address $15 + $16
TEMP_I = $17                                      // 
TEMP_O = $19                                      // 
TEXTBOXLEN = $1A                                  // length of the input field
CHARINDEX = $3f                                   // 
TEXTPOINTER = $40                                 // $40, $41 are a pointer.
TEXTLEN = $83                                     // 
ROWCRS = $54                                      // cursor row
COLCRS = $55                                      // cursor colm
MESSAGEFIELD = $43                                // 43 and 44 hold a pointer to the main input field 
SPLITINDEX = $46                                  // 
                                                  // 
CURSORINH = $2F0                                  // cursor inhibit, cursor is invisible if value is not zero
SAVMSC        = $0058                             // screen memory pointer (lo/hi)                                                  // 
                                                  // 
  org $2000                                       // program starts at $2000
                                                  // 
init                                              // 
  mva #0 $52                                      // set left margin to zero
  clc                                             // we need to do some addition, so clear the carry bit first
  lda SAVMSC                                      // load the lowbyte of the pointer for screen memory
  adc #72                                         // add 72
  sta MESSAGEFIELD                                // store in $43
  clc                                             // we need to do some addition, so clear the carry bit first
  lda SAVMSC+1                                    // load the high byte
  adc #3                                          // add 3
  sta MESSAGEFIELD+1                              // store in $44.
  lda #0                                          // 
  sta CHARINDEX                                   // 
  sta inhsend                                     // 
  sta doswitch                                    // 
  sta FIRSTDOWN                                   //
  sta SCROLLMODE                                  //
  sta restoreMessageLines                         // 
  sta MENU_ID                                     // 
  sta SCREEN_ID                                   // 
  lda SAVMSC                                      // 
  sta TEXTBOX                                     // 
  lda SAVMSC+1                                    // 
  sta TEXTBOX+1                                   // 
  lda #170                                        //
  sta TIMEOUTVALUE                                //
                                                  //
create_screen_lines_lookup_table:                 // 
  lda SAVMSC                                      //  
  sta TEMP_I                                      //
  sta screenLinesLow                              //
  lda SAVMSC+1                                    //
  sta TEMP_I +1                                   //
  sta screenLinesHigh                             //
  ldx #1                                          //
sl_copy_loop                                      //
  clc                                             //
  lda TEMP_I                                      //
  adc #40                                         //
  sta screenLinesLow,x                            //
  sta TEMP_I                                      //
  bcs up_slh                                      //
  lda TEMP_I +1                                   //
  sta screenLinesHigh,x                           //
  sta TEMP_I+1                                    //
  jmp cnt_sl                                      //
up_slh                                            //
  ldy TEMP_I +1                                   //
  iny                                             //
  tya                                             //
  sta screenLinesHigh,x                           //
  sty TEMP_I +1                                   //
cnt_sl                                            //
  inx                                             //
  cpx #22                                         //
  bne sl_copy_loop                                //
                                                  //
main                                              // 
  jsr are_we_in_the_matrix                        // 
  jsr startScreen                                 // 
  jsr hide_cursor                                 // 
  jsr calculate_screen_addresses                  // 
  jsr clear_keyboard_and_screen                   // 
                                                  // 
  jsr get_status                                  // 
  lda CONFIG_STATUS                               // 
  cmp #100                                        // if status != d, go to wifi setup
  bne jmp_main_menu                               // 
  jmp main_chat_screen                            // 
                                                  // 
jmp_main_menu                                     // 
  jmp main_menu                                   // 

// ----------------------------------------------------------------------
// Print the last used pmuser on screen to start your private message
// ----------------------------------------------------------------------
print_pm_user:                                    // 
  lda SCREEN_ID                                   // 
  cmp #3                                          // 
  beq print_pm_continue                           // 
  rts                                             // 
print_pm_continue                                 // 
  mwa MESSAGEFIELD TEMP_I                         // 
//  dec TEMP_I                                      // 
  ldy #0                                          // 
  sty COLCRS                                      // 
  lda #28                                         // move the cursor out of the way
  jsr write_text                                  // 
ploop                                             // 
  lda PMUSER,y                                    // 
  cmp #128                                        // 
  beq exit_print_pm                               // 
  sta (TEMP_I),y                                  // 
  iny                                             // 
  inc COLCRS                                      // 
  jmp ploop                                       // 
                                                  // 
exit_print_pm                                     // 
  lda #29                                         // down one line
  jsr write_text                                  // 
  lda #32                                         // write the @ sign again (work around a bug)
  ldy #0                                          // 
  sta (TEMP_I),y                                  // 
  lda #32                                         // 
  jsr write_text                                  // 
  rts                                             // 
                                                  // 
// ----------------------------------------------------------------------
// toggle between private and public messaging
// ----------------------------------------------------------------------
toggle_screens:                                   // 
  jsr backup_screen                               // make a backup of the current screen
  jsr sound_zipp                                  // 
  lda SCREEN_ID                                   // 
  cmp #3                                          // 
  bne private_chat_screen                         // 
  jmp main_chat_screen                            // 
                                                  // 
// ----------------------------------------------------------------------
// PRIVATE MESSAGING SCREEN
// ----------------------------------------------------------------------
private_chat_screen:                              // 
  mva #3 SCREEN_ID                                // 
  jmp restore_screen                              // 
                                                  // 
p_chat                                            // 
  jsr clear_keyboard_and_screen                   // 
  displayText DIVIDER_LINE, #0,#0                 // draw the divider line
  displayText TEXT_F5_TOGGLE, #1,#0               // draw the menu title
  displayText DIVIDER_LINE, #2,#0                 // draw the divider line
  jmp chat_screen                                 // 
                                                  // 
                                                  // 
// ----------------------------------------------------------------------
// PUBLIC MESSAGING SCREEN
// ----------------------------------------------------------------------
main_chat_screen:                                 // 
  mva #0 SCREEN_ID                                // 
  jmp restore_screen                              // 
m_chat                                            // 
  jsr clear_keyboard_and_screen                   // 
chat_screen                                       // 
                                                  // 
  lda VICEMODE                                    // 
  cmp #1                                          // 
  beq mc_vice                                     // 
  jmp mc_not_vice
mc_vice
  lda #148                                        // 
  sta COLOR4                                      // 
  sta COLOR2                                      // 
  jsr error_sound                                 // 
   
  displayText TEXT_NO_CARTRIDGE, #5,#6            // 
  //displayText FakeChat, #0,#0                                                
  //displayText FakeChat2,#5,#0  // 
  //displayText FakeChat3,#12,#0  // 
  //displayText FakeChat4,#18,#0  // 
  
mc_not_vice                                       // 
                                                  // 
  mva #255 $2fc                                   // clear keyboard buffer
  mva #0 COLCRS                                   // set cursor row position to zero
  displayText DIVIDER_LINE, #20,#0                // draw the divider line
                                                  // 
  jsr clear_input_lines                           // 
chat_key_input                                    // 
  jsr hide_cursor                                 // 
  jsr restore_message_lines                       // 
  jsr show_cursor                                 // 
  jsr print_pm_user                               // 
  jmp text_input                                  // jump to the text input routine
                                                  // 
                                                  // 
                                                  // 
// ----------------------------------------------------------------------
// shift public screen down for scrolling
// ----------------------------------------------------------------------
shift_screen_down:  
  sei                                             // disable interrupts again
  ldx #18
all_lines
  lda screenLinesLow,x
  sta TEMP_I
  lda screenLinesHigh,x
  sta TEMP_I + 1
  inx 
  lda screenLinesLow,x
  sta TEMP_O
  lda screenLinesHigh,x
  dex
  sta TEMP_O + 1
  ldy #39
clloop  
  lda (TEMP_I),y
  sta (TEMP_O),y
  dey
  cpy #255
  bne clloop  
  dex
  cpx #255
  bne all_lines
  // clear line zero
  lda screenLinesLow
  sta TEMP_I
  lda screenLinesHigh
  sta TEMP_I + 1
  ldy #39
  lda #0
clearlp
  sta (TEMP_I),y
  dey
  cpy #255
  bne clearlp 
  cli                                             // enable interrupts again
  rts
  //   

// ----------------------------------------------------------------------
// shift screen up
// ----------------------------------------------------------------------
shift_screen_up:                                  // 
  sei
  lda SCREEN_ID                                   // see on what screen we are
  cmp #3                                          // in private screen, we must ignore the first 3 lines
  bne shift_public                                // 
  ldx #16                                         // 
  mwa SAVMSC              TEMP_I                  // TEMP_I points to line 0
  mwa SAVMSC              TEMP_O                  // 
  lda TEMP_I                                      // 
  adc #120                                        // 
  sta TEMP_I                                      // TEMP_I now points to line 3
  lda TEMP_O                                      // 
  adc #160                                        // 
  sta TEMP_O                                      // TEMP_O points to line 4
  jmp sh_up_d                                     // start shifting!
                                                  // 
shift_public                                      // 
  ldx #19                                         // in public chat we shift from line 0
  mwa SAVMSC              TEMP_I                  // TEMP_I points to line 0
  mwa SAVMSC              TEMP_O                  // 
shift_loop                                        // 
  clc                                             // 
  lda TEMP_O                                      // 
  adc #40                                         // add 40 to go to the next line
  sta TEMP_O                                      // TEXTPOINTER points to line 1
  bcs up_hb                                       // we there was an overflow, increase the highbyte also
  jmp sh_up_d                                     // 
up_hb                                             // 
  inc TEMP_O+1                                    // increase highbyte
sh_up_d                                           // 
  jsr shift_line_up                               // 
  mwa TEMP_O TEMP_I                               // 
  dex                                             // 
  bne shift_loop                                  // 
  mwa STARTLINE1 TEMP_I                           // clear the last line
  ldy #39                                         // 
  lda #0                                          // 
line_clear_loop                                   // 
  sta (TEMP_I),y                                  // 
  dey                                             // 
  bne line_clear_loop                             //  
  rts                                             // 
                                                  // 
shift_line_up:                                    // this routine shifts one line up
  ldy #0                                          // TEMP_O is source
shift_line_loop                                   // TEMP_I is destination
  lda (TEMP_O),y                                  // 
  sta (TEMP_I),y                                  // 
  iny                                             // 
  cpy #40                                         // 
  bne shift_line_loop                             // 
  cli                                             // enable interrupts again
  rts                                             // 
                                                  // 
// ----------------------------------------------------------------------
// backup and restore screens
// ----------------------------------------------------------------------
backup_screen:                                    // 
  mva ROWCRS TEMPBYTE                             // 
  jsr move_cursor_out_of_the_way                  // 
  lda MENU_ID                                     // 
  cmp #0                                          // 
  beq bs_c                                        // 
  rts                                             // 
bs_c                                              // 
  lda SCREEN_ID                                   // 
  cmp #3                                          // 
  beq backup_priv_screen                          // 
  jmp backup_publ_screen                          // 
  rts                                             // 
                                                  // 
backup_priv_screen                                // 
  mva COLCRS PCURSORX                             // 
  mva TEMPBYTE PCURSORY                           // 
  mva #1 HAVE_P_BACKUP                            // 
  mva #<SCREEN_PRIV_BACKUP TEMP_I                 // 
  mva #>SCREEN_PRIV_BACKUP TEMP_I+1               // 
  jsr backup_the_screen                           // 
  rts                                             // 
                                                  // 
backup_publ_screen                                // 
  mva COLCRS MCURSORX                             // 
  mva TEMPBYTE MCURSORY                           // 
  mva #1 HAVE_M_BACKUP                            // 
  mva #<SCREEN_PUBL_BACKUP TEMP_I                 // 
  mva #>SCREEN_PUBL_BACKUP TEMP_I+1               // 
  jsr backup_the_screen                           // 
  rts                                             // 
                                                  // 
backup_the_screen                                 // 
  mwa SAVMSC              TEXTPOINTER             // 
  ldy #0                                          // 
backup_loop1                                      // 
  lda (TEXTPOINTER),y                             // 
  sta (TEMP_I),y                                  // 
  iny                                             // 
  cpy #0                                          // 
  bne backup_loop1                                // 
                                                  // 
  inc TEXTPOINTER+1                               // 
  inc TEMP_I+1                                    // 
backup_loop2                                      // 
  lda (TEXTPOINTER),y                             // 
  sta (TEMP_I),y                                  // 
  iny                                             // 
  cpy #0                                          // 
  bne backup_loop2                                // 
                                                  // 
  inc TEXTPOINTER+1                               // 
  inc TEMP_I+1                                    // 
backup_loop3                                      // 
  lda (TEXTPOINTER),y                             // 
  sta (TEMP_I),y                                  // 
  iny                                             // 
  cpy #0                                          // 
  bne backup_loop3                                // 
                                                  // 
  inc TEXTPOINTER+1                               // 
  inc TEMP_I+1                                    // 
backup_loop4                                      // 
  lda (TEXTPOINTER),y                             // 
  sta (TEMP_I),y                                  // 
  iny                                             // 
  cpy #192                                        // 
  bne backup_loop4                                // 
  rts                                             // 
                                                  // 
                                                  // 
restore_screen:                                   // 
  lda SCREEN_ID                                   // 
  cmp #3                                          // 
  beq restore_priv_screen                         // 
  jmp restore_publ_screen                         // 
                                                  // 
restore_priv_screen                               // 
  lda HAVE_P_BACKUP                               // 
  cmp #1                                          // 
  beq do_p_restore                                //  
  jmp p_chat                                      // 
do_p_restore                                      // 
  mva #<SCREEN_PRIV_BACKUP TEMP_I                 // 
  mva #>SCREEN_PRIV_BACKUP TEMP_I+1               // 
  jsr restore_the_screen                          // 
  mva PCURSORX COLCRS                             // restore the cursor position
  mva PCURSORY ROWCRS                             // restore the cursor position
  jmp chat_key_input                              // 
                                                  // 
restore_publ_screen                               // 
  lda HAVE_M_BACKUP                               // 
  cmp #1                                          // 
  beq do_m_restore                                // 
  jmp m_chat                                      // 
do_m_restore                                      // 
  mva #<SCREEN_PUBL_BACKUP TEMP_I                 // 
  mva #>SCREEN_PUBL_BACKUP TEMP_I+1               // 
  jsr restore_the_screen                          // 
  mva MCURSORX COLCRS                             // restore the cursor position
  mva MCURSORY ROWCRS                             // restore the cursor position
  jmp chat_key_input                              // 
                                                  // 
restore_the_screen                                // 
  mwa SAVMSC              TEXTPOINTER             // 
  ldy #0                                          // 
restore_loop1                                     // 
  lda (TEMP_I),y                                  // 
  sta (TEXTPOINTER),y                             // 
  iny                                             // 
  cpy #0                                          // 
  bne restore_loop1                               // 
                                                  // 
  inc TEXTPOINTER+1                               // 
  inc TEMP_I+1                                    // 
restore_loop2                                     // 
  lda (TEMP_I),y                                  // 
  sta (TEXTPOINTER),y                             // 
  iny                                             // 
  cpy #0                                          // 
  bne restore_loop2                               // 
                                                  // 
  inc TEXTPOINTER+1                               // 
  inc TEMP_I+1                                    // 
restore_loop3                                     // 
  lda (TEMP_I),y                                  // 
  sta (TEXTPOINTER),y                             // 
  iny                                             // 
  cpy #0                                          // 
  bne restore_loop3                               // 
                                                  // 
  inc TEXTPOINTER+1                               // 
  inc TEMP_I+1                                    // 
restore_loop4                                     // 
  lda (TEMP_I),y                                  // 
  sta (TEXTPOINTER),y                             // 
  iny                                             // 
  cpy #192                                        // 
  bne restore_loop4                               // 
  rts                                             // 
                                                  // 
backup_message:                                   // 
  jsr move_cursor_out_of_the_way                  // 
  ldy #0                                          // 
  mwa MESSAGEFIELD TEMP_I                         // 
//  dec TEMP_I                                      // 
ml_b_loop                                         // backup message lines
  lda (TEMP_I),y                                  // 
  sta MESSAGE_LINES_BACKUP,y                      // 
  iny                                             // 
  cpy #120                                        // 
  bne ml_b_loop                                   // 
  rts                                             // 
                                                  // 
move_cursor_out_of_the_way:                       // 
crs_up                                            // 
  lda #28                                         // 
  jsr write_text                                  // 
  lda ROWCRS                                      // 
  cmp #20                                         // 
  bne crs_up                                      // 
  jsr hide_cursor                                 // 
  rts                                             // 
                                                  // 
restore_message_lines:                            // 
  lda SCREEN_ID                                   // 
  cmp #3                                          // 
  bne rml_exit                                    // 
  lda restoreMessageLines                         // 
  cmp #1                                          // 
  bne rml_exit                                    // 
  jsr move_cursor_out_of_the_way                  // 
  ldy #0                                          // 
  mwa MESSAGEFIELD TEMP_I                         // 
//  dec TEMP_I                                      // 
rms_loop                                          // 
  lda MESSAGE_LINES_BACKUP,y                      // 
  sta (TEMP_I),y                                  // 
  iny                                             // 
  cpy #120                                        // 
  bne rms_loop                                    // 
  lda #0                                          // 
  sta restoreMessageLines                         // 
  jsr sound_zipp                                  // 
  jsr sound_zipp                                  // 
  jsr sound_zipp                                  // 
  lda #29                                         // 
  jsr write_text                                  // 
  mva PCURSORX COLCRS                             // 
  mva PCURSORY ROWCRS                             // 
                                                  // 
rml_exit                                          // 
  rts                                             // 
                                                  // 
// ----------------------------------------------------------------------
// Get wifi status and fill variable WIFISTATUS
// ----------------------------------------------------------------------
get_wifi_status:                                  // 
  lda VICEMODE                                    // 
  cmp #1                                          // 
  bne get_wifi_status_cont                        // 
  rts                                             // 
get_wifi_status_cont                              // 
  lda #248                                        // 
  jsr send_start_byte                             // the first byte in the RXBUFFER now contains 1 or 0
  lda RXBUFFER                                    // get the first byte of the RXBUFFER
  sta WIFISTATUS                                  // store the first byte as WIFISTATUS
  lda #32
  sta RXBUFFER
  rts                                             // 
// ----------------------------------------------------------------------
// Get the config status and the ESP Version
// ----------------------------------------------------------------------
get_status:                                       // 
  lda VICEMODE                                    // 
  cmp #1                                          // 
  beq exit_gs                                     // 
                                                  // 
  lda #236                                        // ask Cartridge for the config status, server name and esp sketch version
  jsr send_start_byte                             // the RXBUFFER now contains Configured<byte 129>Server<byte 129>SWVersion<byte 128>
                                                  // 
  lda #1                                          // set the variables up for the splitbuffer command
  sta SPLITINDEX                                   // we need the first element, so store #1 in SPLITINDEX
  jsr splitRXbuffer                               // and call spilt buffer
  lda SPLITBUFFER                                 // SPLITBUFFER NOW CONTAINS THE CONFIG_STATUS
  sta CONFIG_STATUS                               // this is only one character, store it in config_status
                                                  // 
  lda #2                                          // we need the second element out of the rxbuffer
  sta SPLITINDEX                                   // so put #2 in SPLITINDEX and jump to split buffer
  jsr splitRXbuffer                               // SPLITBUFFER NOW CONTAINS THE SERVERNAME
                                                  // The servername is multiple characters so we need a loop to copy it to
  ldx #0                                          // the server name variable
read_server_name                                  // start of the loop
  lda SPLITBUFFER,x                               // load a character from the splitbuffer
  sta SERVERNAME,x                                // store it in the servername variable
  cmp #32                                         // see if the character was a space character
  beq fin_server_name                             // if so, jump out of the loop
  cmp #128                                        // see if the character was byte 128
  beq fin_server_name                             // if so, jump out of the loop
  inx                                             // increase x for the next character
  jmp read_server_name                            // and repeat
fin_server_name                                   // 
  lda #128                                        // finish the servername variable with byte 128
  sta SERVERNAME,x                                // 
  lda #3                                          // now get the third element from the rx buffer
  sta SPLITINDEX                                   // so put #3 in SPLITINDEX and jump to split buffer
  jsr splitRXbuffer                               // SPLITBUFFER NOW CONTAINS THE SWVERSION
                                                  // The swversion is multiple characters so we need a loop
  ldx #0                                          // to copy the text to the SWVERSION variable
read_swversion                                    // start of the loop
  lda SPLITBUFFER,x                               // load a character from the splitbuffer
  sta SWVERSION,x                                 // store it in the SWVERSION variable
  cmp #32                                         // see if the character was a space character
  beq fin_swversion                               // if so, jump out of the loop
  cmp #128                                        // see if the character was byte 128
  beq fin_swversion                               // if so, jump out of the loop
  inx                                             // increase x for the next character
  jmp read_swversion                              // and repeat
fin_swversion                                     // 
  lda #128                                        // 
  sta SWVERSION,x                                 // finish the SWVERSION variable with byte 128
                                                  // 
exit_gs                                           // 
  rts                                             // 
                                                  // 
                                                  // 
reset_screen:                                     // 
  jsr clear_keyboard_and_screen                   // 
  displayText DIVIDER_LINE, #0,#0                 // draw the divider line
  displayText text_reset_screen, #1,#11           // draw the menu title
  displayText DIVIDER_LINE, #2,#0                 // draw the divider line
  displayText text_reset_screen_1, #4, #0         // 
  displayText DIVIDER_LINE, #22,#0                // draw the divider line
get_reset_choice                                  // 
  jsr getKey                                      // 
  cmp #255                                        // 
  beq get_reset_choice                            // 
  cmp #121                                        // if user pressed y, do the reset
  bne exit_account_setup                          // any other key cancels the reset
  lda #244                                        // do the reset
  jsr wait_for_RTR                                // 
  sta $d502                                       // 
  ldy #0                                          // 
confirm_reset                                     // 
  jsr WAIT_FOR_RTR                                // 
  lda CONFIRMRESET,y                              // 
  sta $D502                                       // 
  iny                                             // 
  cmp #128                                        // 
  bne confirm_reset                               // 
  jmp $E477                                       // jump to reboot vector to restart the Atari.
                                                  // 
                                                  // 
exit_account_setup                                // 
  jmp account_setup                               // 
// ----------------------------------------------------------------------
// Main Menu
// ----------------------------------------------------------------------
main_menu:                                        // 
  jsr get_status                                  // 
  jsr displayUpdateScreen                         // 
  mva #10 MENU_ID                                 // 
  jsr clear_keyboard_and_screen                   // 
  displayText DIVIDER_LINE, #0,#0                 // draw the divider line
  displayText text_main_menu, #1,#15              // draw the menu title
  displayText DIVIDER_LINE, #2,#0                 // draw the divider line
                                                  // 
  displayText MLINE_MAIN1, #5,#3                  // wifi setup
                                                  // 
  lda CONFIG_STATUS                               // 
  cmp #101                                        // e
  bne main2                                       // 
  jmp skip_mm1                                    // 
main2                                             // 
  displayText MLINE_MAIN2, #7,#3                  // server setup
  lda CONFIG_STATUS                               // 
  cmp #119                                        // w
  bne acc_stup                                    // 
  jmp skip_mm1                                    // 
acc_stup                                          // 
  displayText MLINE_MAIN3, #9,#3                  // account setup
  lda CONFIG_STATUS                               // 
  cmp #115                                        // s
  bne more_items                                  // 
  jmp skip_mm1                                    // 
more_items                                        // 
  displayText MLINE_MAIN4, #11,#3                 // 
  displayText MLINE_MAIN5, #13,#3                 // 
  displayText MLINE_MAIN6, #15,#3                 // 
  displayText MLINE_MAIN8, #17,#3                 // 
  displayText MLINE_MAIN7, #19,#3                 // 

skip_mm1                                          // 
  displayText DIVIDER_LINE, #22,#0                // draw the divider line
  displayText VERSION_LINE, #23,#0                // draw the version line

  displayBuffer SWVERSION,#23,#24,#0              // 
  displayBuffer VERSION,#23,#14,#0                //   
  displayBuffer VERSION_DATE #23,#32,#0           // 

main_menu_key_input:                              // 
  jsr getKey                                      // 
  cmp #255                                        // 
  beq main_menu_key_input                         // 
                                                  // 
  cmp #251                                        // Escape is pressed(exit)
  beq exit_main_menu                              // 
                                                  // 
  cmp #$31                                        // key 1 is pressed (wifi)
  bne cp_2                                        // 
  jmp wifi_setup                                  // 
cp_2                                              // 
  cmp #$32                                        // key 2 is pressed (server setup)
  bne cp_3                                        // 
  jmp account_setup                               // 
cp_3                                              // 
  cmp #$33                                        // key 3 is pressed (account)
  bne cp_4                                        // 
  jmp server_setup                                // 
cp_4                                              // 
  cmp #$34                                        // key 4 is pressed (user list)
  bne cp_5                                        // 
  jmp user_list                                   // 
cp_5                                              // 
  cmp #$35                                        // key 5 is pressed (about)
  bne cp_6                                        // 
  jmp about_screen                                // 
cp_6                                              // 
  cmp #$36                                        // key 6 is pressed (help)
  bne cp_c                                        // 
  jmp help_screen                                 // 
                                                  // 
cp_c                                              // change color
  cmp #62                                         // c
  bne cp_x                                        // 
  inc COLOR4                                      // 
  inc COLOR4                                      // 
  inc COLOR2                                      // 
  inc COLOR2                                      // 
  jmp no_match                                    // 
cp_x                                              // 
  cmp #60                                         // 
  bne no_match                                    // 
  dec COLOR4                                      // 
  dec COLOR4                                      // 
  dec COLOR2                                      // 
  dec COLOR2                                      // 
  jmp no_match                                    // 
                                                  // 
no_match                                          // 
  mva #255 $2fc                                   // clear keyboard buffer
  jmp main_menu_key_input                         // 
                                                  // 
exit_main_menu                                    // 
  lda #0                                          // 
  sta MENU_ID                                     // 
  mva #255 $2fc                                   // clear keyboard buffer
                                                  // 
  jsr sendScreenColor                             // send the screen color
  jmp restore_screen                              // 
                                                  // 
// ----------------------------------------------------------------------
// Send screen color
// ----------------------------------------------------------------------
sendScreenColor:                                  // 
  jsr wait_for_RTR                                // 
  lda #230                                        // 
  sta $D502                                       // 
  jsr wait_for_RTR                                // 
  lda COLOR4                                      // 
  sta $D502                                       // 
  jsr wait_for_RTR                                // 
  rts                                             // 
                                                  // 
// ----------------------------------------------------------------------
// Update screen, shown if there is a new firmware version available
// ----------------------------------------------------------------------
                                                  // 
displayUpdateScreen:                              // 
  lda NEWESP                                      // 
  cmp #128                                        // if newesp version starts with 128
  bne contUpdateScreen                            // then there is no new version to show
  rts                                             // so return without further action
contUpdateScreen                                  // 
  mva #19 MENU_ID                                 // 
  jsr clear_keyboard_and_screen                   // 
  displayText DIVIDER_LINE, #0,#0                 // draw the divider line
  displayText TEXT_UPDATE_TITLE, #1,#10           // draw the menu title
  displayText DIVIDER_LINE, #2,#0                 // draw the divider line
  displayText TEXT_NEW_VERSIONS,#5,#0             // 
  displayText TEXT_NEW_ROM, #8,#2                 // 
  displayText TEXT_NEW_ESP, #9,#2                 // 
  displayBuffer NEWROM, #8,#11,#0                 // 
  displayBuffer NEWESP, #9,#11,#0                 // 
                                                  // 
  displayText DIVIDER_LINE, #22,#0                // draw the divider line
  displayText VERSION_LINE, #23,#0                // draw the version line
  displayBuffer SWVERSION,#23,#24,#0              // 
  displayBuffer VERSION,#23,#14,#0                // 
                                                  // 
updateScreenKeyInput:                             //   
  jsr getKey                                      // 
  cmp #255                                        // 
  beq updateScreenKeyInput                        // 
                                                  // 
  cmp #251                                        // Escape is pressed(exit)
  beq exitUpdateScreen                            // 
                                                  // 
  cmp #121                                        // key y is pressed
  bne cp_n                                        // 
  jmp doUpdate                                    // 
cp_n                                              // 
  cmp #110                                        // 
  bne updateScreenKeyInput                        // 
  lda #128                                        // key n is pressed
  sta NEWESP                                      // 
                                                  // 
exitUpdateScreen                                  // 
  rts                                             // 
                                                  // 
doUpdate                                          // 
  displayText TEXT_INSTALLING, #11,#2             // 
  displayBuffer UPDATEBOX, #13,#2,#0              // 
  lda #$9b                                        // go to next line
  jsr write_text                                  // 
  lda #$1f                                        // right
  jsr write_text                                  //                                                   
  lda #$1f                                        // right
  jsr write_text                                  // 
  lda #$1f                                        // right
  jsr write_text                                  // // 
  jsr WAIT_FOR_RTR                                // 
  lda #231                                        // 
  sta $D502                                       // 
  ldy #0                                          // 
confirmUpd                                        // 
  jsr WAIT_FOR_RTR                                // 
  lda CONFIRMUPDATE,y                             // 
  sta $D502                                       // 
  iny                                             // 
  cmp #128                                        // 
  bne confirmUpd                                  // 
  jsr WAIT_FOR_RTR                                // 
updt                                              // 
  lda #100                                        // 
  sta DELAY                                       // 
  jsr jdelay                                      // 
  lda $D502                                       // 
  cmp #32                                         // 
  beq updRest                                     // 
  sta TEMPBYTE                                    // 
                                                  // 
pbar                                              // 
  lda #160                                        // 
  jsr write_text                                  // 
  dec TEMPBYTE                                    // 
  lda TEMPBYTE                                    // 
  cmp #0                                          // 
  bne pbar                                        // 
                                                  // 
  lda #$9b                                        // go to next line
  jsr write_text                                  // 
  lda #$1c                                        // up
  jsr write_text                                  // 
  lda #$1f                                        // right
  jsr write_text                                  // 
  lda #$1f                                        // right
  jsr write_text                                  // 
  lda #$1f                                        // right
  jsr write_text                                  // 
  lda #$1f                                        // right
  jsr write_text                                  // 
  jmp updt                                        // 
  rts                                             // 
                                                  // 
updRest                                           // 
  displayText UPDATEDONE,#17,#2                   // 
  lda #254                                        // 
  sta DELAY                                       // 
  jsr doubledelay                                 //  
  jmp $E477                                       // 
// ----------------------------------------------------------------------
// Clear the keyboardbuffer and also clear the screen
// ----------------------------------------------------------------------
clear_keyboard_and_screen                         // 
  mva #255 $2fc                                   // clear keyboard buffer
  lda #$7D                                        // load clear screen command
  jsr write_text                                  // print it to screen
  rts                                             // 
                                                  // 
// ----------------------------------------------------------------------
// About screen
// ----------------------------------------------------------------------
about_screen:                                     // 
  mva #15 MENU_ID                                 // 
  jsr clear_keyboard_and_screen                   // 
  displayText DIVIDER_LINE, #0,#0                 // draw the divider line
  displayText DIVIDER_LINE, #2,#0                 // draw the divider line
  displayText TEXT_ABOUT_SCREEN, #1,#15           // draw the menu title and text  
  displayText TEXT_ABOUT_SCREEN1, #3,#0
  displayText TEXT_ABOUT_SCREEN2, #10,#0          // draw the more text
                                                  // 
  displayText DIVIDER_LINE, #22,#0                // draw the divider line
  displayText MLINE_MAIN7, #23,#1                 // draw the menu on the bottom line
  jmp help_get_key_input                          // wait for user to press esc to exit
// ----------------------------------------------------------------------
// Help screen
// ----------------------------------------------------------------------
help_screen:                                      // 
  mva #16 MENU_ID                                 // 
  jsr clear_keyboard_and_screen                   // 
  displayText DIVIDER_LINE, #0,#0                 // draw the divider line
  displayText TEXT_HELP_SCREEN, #1,#15            // draw the menu title and text
  displayText TEXT_HELP_SCREEN1, #3,#0            // draw the menu title and text
  displayText TEXT_HELP_SCREEN2, #10,#0           // draw more text
  displayText TEXT_HELP_SCREEN3, #14,#0           // draw more text

  displayText DIVIDER_LINE, #2,#0                 // draw the divider line
  displayText DIVIDER_LINE, #22,#0                // draw the divider line
  displayText MLINE_MAIN7, #23,#1                 // draw the menu on the bottom line
                                                  // 
help_get_key_input                                // 
  jsr getKey                                      // wait for a key
  cmp #251                                        // wait for ESC key
  bne help_get_key_input                          // if not, wait for key again
hlp_exit                                          // 
  mva #255 $2fc                                   // clear keyboard buffer
  jmp main_menu                                   // exit to main menu
                                                  // 
                                                  // 
                                                  // 
// ----------------------------------------------------------------------
// User list screen
// send byte 234 to reset the page number to 0 and get the first group of 20 users
// send byte 233 to get the next group of 20 users
// so we have 40 users on screen.
// at this point we support a max of 120 users per chat server.
// ----------------------------------------------------------------------
user_list:                                        // 
  mva #14 MENU_ID                                 // 
  mva #234 TEMPBYTE                               // 
ul_start                                          // 
  jsr clear_keyboard_and_screen                   // 
  displayText DIVIDER_LINE, #0,#0                 // draw the divider line
  displayText TEXT_USER_LIST, #1,#1               // draw the menu title
  displayText DIVIDER_LINE, #2,#0                 // draw the divider line
  displayText DIVIDER_LINE, #22,#0                // draw the divider line
  displayText TEXT_USER_LIST_foot, #23,#1         // draw the menu on the bottom line
  lda VICEMODE                                    // 
  cmp #1                                          // 
  bne ul_novice                                   // 
  jmp ul_vice                                     // 
                                                  // 
ul_novice                                         // 
  lda TEMPBYTE                                    // 
  jsr send_start_byte                             // RXBUFFER now contains the first group of users, 20
  displayBuffer RXBUFFER,#4 ,#0,#0                // 
                                                  // 
  lda #233                                        // 
  jsr send_start_byte                             // RXBUFFER now contains the second group of users, 40
  displayBuffer RXBUFFER,#9 ,#0,#0                // 
                                                  // 
  lda #233                                        // 
  jsr send_start_byte                             // RXBUFFER now contains the second group of users, 40
  displayBuffer RXBUFFER,#14 ,#0,#0               // 
                                                  // 
  displayText DIVIDER_LINE, #22,#0                // draw the divider line
  displayText TEXT_USER_LIST_foot, #23,#1         // draw the menu on the bottom line
                                                  // 
ul_vice                                           // 
ul_get_key_input                                  // 
  jsr getKey                                      // 
                                                  // cmp #$37
  cmp #251                                        // ESC key is pressed
  beq ul_exit_main_menu                           // 
  cmp #$6E                                        // key 'n' is pressed
  beq ul_next                                     // 
  cmp #$70                                        // key 'p' is pressed
  beq ul_prev                                     // 
  jmp ul_get_key_input                            // 
                                                  // 
ul_next                                           // 
  mva #233 TEMPBYTE                               // 
  jmp ul_start                                    // 
                                                  // 
ul_prev                                           // 
  jmp user_list                                   // 
                                                  // 
ul_exit_main_menu                                 // 
  jmp main_menu                                   // 
                                                  // 
// ----------------------------------------------------------------------
// Account_setup screen
// ----------------------------------------------------------------------
account_setup:                                    // 
  mva #13 MENU_ID                                 // 
  jsr clear_keyboard_and_screen                   // 
  lda #29                                         // down one line
  jsr write_text   

  displayText DIVIDER_LINE, #0,#0                 // draw the divider line
  displayText TEXT_ACCOUNT_SETUP, #1,#15          // draw the menu title
  displayText DIVIDER_LINE, #2,#0                 // draw the divider line
  displayText TEXT_ACCOUNT_1, #5,#1               // 
                                                  // 
  displayText DIVIDER_LINE, #11,#0                // draw the divider line
  displayText TEXT_OPTION_EXIT, #15,#3            // 
  displayText TEXT_FACTORY_RESET, #17,#3          // 
  displayText DIVIDER_LINE, #22,#0                // draw the divider line
                                                  // 
  lda VICEMODE                                    // 
  cmp #1                                          // 
  bne acc_novice                                  // 
  jmp acc_vice                                    // 
acc_novice                                        // 
  lda #243                                        // ask for the mac address, registration id, nickname and regstatus
  jsr send_start_byte                             // the RXBUFFER now contains: macaddress(129)regID(129)NickName(129)regStatus(128)
  mva #1 SPLITINDEX                                // 
  jsr splitRXbuffer                               // 
  displayBuffer  SPLITBUFFER,#5 ,#14,#0           // Display the buffers on screen (Mac address)
  mva #2 SPLITINDEX                                // 
  jsr splitRXbuffer                               // 
  displayBuffer  SPLITBUFFER,#7 ,#18,#0           // Display the buffers on screen (registration id)
  mva #3 SPLITINDEX                                // 
  jsr splitRXbuffer                               // 
  displayBuffer  SPLITBUFFER,#9 ,#12,#0           // Display the buffers on screen (Nick Name)
  mva #4 SPLITINDEX                                // 
  jsr splitRXbuffer                               // 
  lda SPLITBUFFER                                 // 
  cmp #120                                        // 120 = x  some unknown error
  bne cp_114                                      // 
  displayText text_reg_x,#23 ,#6                  // 
  jmp acc_input_fields                            // 
cp_114                                            // 
  cmp #114                                        // 114 = r
  bne cp_117                                      // 
  displayText text_reg_r,#23 ,#5                  // 
  jmp acc_input_fields                            // 
cp_117                                            // 
  cmp #117                                        // 117 = u
  bne cp_110                                      // 
  displayText text_reg_u,#23 ,#4                  // 
  jmp acc_input_fields                            // 
cp_110                                            // 
  cmp #110                                        // 110 = n
  bne acc_input_fields                            // 
  displayText text_reg_n,#23 ,#5                  // 
                                                  // 
acc_vice                                          // 
acc_input_fields                                  // 
  mva #7 ROWCRS                                   // Put the cursor in the registration id field
  mva #17 COLCRS                                  // 
  jsr show_cursor                                 // 
  mva #19 FIELD_MIN                               // 
  mva #35 FIELD_MAX                               // 
  lda #32                                         // 
  jsr write_text                                  // 
  jsr text_input                                  // 
                                                  // 
  mva #255 $2fc                                   // Clear keyboard buffer
  mva #9 ROWCRS                                   // Put the cursor in the Nick Name field
  mva #11 COLCRS                                  // 
  mva #13 FIELD_MIN                               // 
  mva #21 FIELD_MAX                               // 
  lda #32                                         // 
  jsr write_text                                  // 
  jsr text_input                                  // 
  jsr hide_cursor                                 // 
                                                  // 
  displayText text_start_save_settings, #13,#3    // 
account_setup_key_input:                          // 
  jsr getKey                                      // 
  cmp #255                                        // 
  beq account_setup_key_input                     // 
  cmp #251                                        // OPTION is pressed
  beq exit_to_main_menus                          // 
  cmp #253                                        // START is pressed
  beq account_save_settings                       // 
  mva #255 $2fc                                   // clear keyboard buffer
  jmp account_setup_key_input                     // 
                                                  // 
exit_to_main_menus                                // 
  mva #255 $2fc                                   // clear keyboard buffer
  jmp main_menu                                   // 
                                                  // 
account_save_settings                             // 
  displayText TEXT_SAVE_SETTINGS, #23, #3         // 
  jsr wait_for_RTR                                // 
  lda #240                                        // 
  sta $D502                                       // 
  mva #7 TEMP_I                                   // Read regid and send it to cartridge
  mva #18 TEMP_I+1                                // 
  mva #38 TEXTBOXLEN                              // 
  jsr read_field                                  // 
                                                  // 
  mva #9 TEMP_I                                   // Read nickname and send it to cartridge
  mva #12 TEMP_I+1                                // 
  mva #38 TEXTBOXLEN                              // 
  jsr read_field                                  // 
                                                  // 
                                                  // 
  mva #254 DELAY                                  // 
  jsr doubledelay                                 // 
  jsr doubledelay                                 // 
  jsr get_status                                  // 
  jmp account_setup                               // 
                                                  // 
// ----------------------------------------------------------------------
// Server setup screen
// ----------------------------------------------------------------------
server_setup:                                     // 
                                                  // 
                                                  // 
  mva #12 MENU_ID                                 // 
  jsr clear_keyboard_and_screen                   // 
  lda #29                                         // down one line
  jsr write_text   
  displayText DIVIDER_LINE, #0,#0                 // draw the divider line
  displayText TEXT_SERVER_SETUP, #1,#15           // draw the menu title
  displayText DIVIDER_LINE, #2,#0                 // draw the divider line
  displayText TEXT_SERVER_1, #5,#1                // 
  displayText DIVIDER_LINE, #10,#0                // draw the divider line
  displayText TEXT_OPTION_EXIT, #15,#3            // 
  displayText DIVIDER_LINE, #22,#0                // draw the divider line
  displayBuffer SERVERNAME,#5,#14,#0              // 
  lda VICEMODE                                    // 
  cmp #1                                          // 
  beq svr_vice                                    // 
                                                  // 
  jsr wait_for_RTR                                // 
  lda #238                                        // 
  sta $D502                                       // 
  mva #254 DELAY                                  // 
  jsr tripledelay                                 // 
  lda #237                                        // get server connection status
  jsr send_start_byte                             // 
  displayBuffer  RXBUFFER,#23 ,#3,#0              // the RX buffer now contains the server status
                                                  // 
svr_vice                                          // 
svr_input_fields                                  // 
  mva #5 ROWCRS                                   // Put the cursor in the Server Name field
  mva #13 COLCRS                                  // 
  mva #15 FIELD_MIN                               // 
  mva #38 FIELD_MAX                               // 
  lda #32                                         // 
  jsr write_text                                  // 
  jsr show_cursor                                 // 
  jsr text_input                                  // 
  jsr hide_cursor                                 // 
  displayText text_start_save_settings, #13,#3    // 
                                                  // 
server_setup_key_input:                           // 
  jsr getKey                                      // 
  cmp #255                                        // 
  beq server_setup_key_input                      // 
  cmp #251                                        // OPTION is pressed
  beq srv_exit_to_main_menu                       // 
  cmp #253                                        // START is pressed
  beq server_save_settings                        // 
  mva #255 $2fc                                   // clear keyboard buffer
  jmp server_setup_key_input                      // 
                                                  // 
srv_exit_to_main_menu                             // 
  mva #255 $2fc                                   // clear keyboard buffer
  jmp main_menu                                   // 
                                                  // 
                                                  // 
server_save_settings                              // 
  displayText TEXT_SAVE_SETTINGS, #23, #3         // 
  jsr wait_for_RTR                                // 
  lda #246                                        // 
  sta $D502                                       // 
  mva #5 TEMP_I                                   // Read servername and send it to cartridge
  mva #14 TEMP_I+1                                // 
  mva #25 TEXTBOXLEN                              // 
  jsr read_field                                  // 
                                                  // 
  mva #255 DELAY                                  // 
  jsr jdelay                                      // 
  jsr wait_for_RTR                                // 
  lda #238                                        // 
  sta $D502                                       // 
  jsr tripledelay                                 // 
  jsr get_status                                  // 
  jmp server_setup                                // 
                                                  // 
// ----------------------------------------------------------------------
// Wifi setup screen
// ----------------------------------------------------------------------
wifi_setup:                                       // 
  mva #12 MENU_ID                                 // 
  jsr clear_keyboard_and_screen   
  lda #29                                         // down one line
  jsr write_text   
  displayText DIVIDER_LINE, #0,#0
  displayText TEXT_WIFI_SETUP, #1,#15             // draw the menu title
  displayText DIVIDER_LINE, #2,#0                 // draw the divider line
  displayText TEXT_WIFI_SSID, #5,#3               // 
  displayText TEXT_WIFI_PASSWORD, #7,#3
  displayText TEXT_WIFI_OFFSET, #9,#3
  displayText DIVIDER_LINE, #11,#0                // draw the divider line
  displayText TEXT_OPTION_EXIT, #15,#3            // 
  displayText DIVIDER_LINE, #21,#0                // draw the divider line
  lda VICEMODE                                    // 
  cmp #1                                          // 
  bne wifi_get_cred                               // 
  jmp wf_vice                                     // 
                                                  // 
wifi_get_cred                                     // 
  jsr get_wifi_status                             // 
  displayBuffer  RXBUFFER,#22 ,#3,#1              // the RX buffer now contains the wifi status
  lda #251                                        // ask Cartridge for the wifi credentials
  jsr send_start_byte                             // the RXBUFFER now contains ssid[32]password[32]timeoffset[128]
  mva #1 SPLITINDEX                                // 
  jsr splitRXbuffer                               // 
  displayBuffer  SPLITBUFFER,#5 ,#9,#0            // Display the buffers on screen (SSID name)
  mva #2 SPLITINDEX                                // 
  jsr splitRXbuffer                               // 
  displayBuffer  SPLITBUFFER,#7 ,#13,#0           // Display the buffers on screen (password)
  mva #3 SPLITINDEX                                // 
  jsr splitRXbuffer                               // 
  displayBuffer  SPLITBUFFER,#9 ,#25,#0           // Display the buffers on screen (time offset)
                                                  // 
wf_vice                                           // 
wifi_input_fields                                 // 
  mva #5 ROWCRS                                   // Put the cursor in the SSID field
  mva #8 COLCRS                                   // 
  mva #10 FIELD_MIN                               // 
  mva #35 FIELD_MAX                               // 
  lda #32                                         // 
  jsr write_text                                  // 
  jsr show_cursor                                 // 
  jsr text_input                                  // 
  jsr hide_cursor                                 // 
                                                  // 
  mva #255 $2fc                                   // Clear keyboard buffer
  mva #7 ROWCRS                                   // Put the cursor in the password field
  mva #12 COLCRS                                  // 
  mva #14 FIELD_MIN                               // 
  mva #35 FIELD_MAX                               // 
  lda #32                                         // 
  jsr write_text                                  // 
  jsr show_cursor                                 // 
  jsr text_input                                  // 
  jsr hide_cursor                                 // 
                                                  // 
  mva #255 $2fc                                   // clear keyboard buffer
  mva #9 ROWCRS                                   // put the cursor in the time-offset field
  mva #24 COLCRS                                  // 
  mva #26 FIELD_MIN                               // 
  mva #32 FIELD_MAX                               // 
  lda #32                                         // 
  jsr write_text                                  // 
  jsr show_cursor                                 // 
  jsr text_input                                  // 
  jsr hide_cursor                                 // 
                                                  // 
  displayText text_start_save_settings, #13,#3    // 
wifi_setup_key_input:                             // 
  jsr getKey                                      // 
  cmp #255                                        // 
  beq wifi_setup_key_input                        // 
  cmp #251                                        // OPTION is pressed
  beq exit_to_main_menu                           // 
  cmp #253                                        // START is pressed
  beq wifi_save_settings                          // 
  mva #255 $2fc                                   // clear keyboard buffer
  jmp wifi_setup_key_input                        // 
                                                  // 
exit_to_main_menu                                 // 
  mva #255 $2fc                                   // clear keyboard buffer
  jmp main_menu                                   // 
                                                  // 
wifi_save_settings:                               // 
  displayText TEXT_SAVE_SETTINGS, #23, #3         // 
  jsr wait_for_RTR                                // 
  lda #252                                        // 
  sta $D502                                       // 
  mva #5 TEMP_I                                   // Read SSID and send it to cartridge
  mva #9 TEMP_I+1                                 // TEMP_I (2 bytes) holds the row and column of the field
  mva #27 TEXTBOXLEN                              // TEXTBOXLEN is the length of the field
  jsr read_field                                  // jump to the read_field sub routine
  mva #7 TEMP_I                                   // Read password and send it to cartridge
  mva #13 TEMP_I+1                                // 
  mva #23 TEXTBOXLEN                              // 
  jsr read_field                                  // 
  mva #9 TEMP_I                                   // Read password and send it to cartridge
  mva #25 TEMP_I+1                                // 
  mva #10 TEXTBOXLEN                              // 
  jsr read_field                                  // 
  mva #255 DELAY                                  // wait for wifi
  jsr doubledelay                                 //  
  mva #10 TEMP_I                                  // 
wait_for_wifi                                     // 
  displayText TEXT_COUNTER,#23,#34                // 
  jsr get_wifi_status                             // 
  lda WIFISTATUS                                  // 
  cmp #49                                         // 
  beq exit_wait                                   // 
  jsr doubledelay                                 //  
  lda TEXT_COUNTER+1                              // 
  cmp #49                                         // 
  bne dec2                                        // 
  lda #48                                         // 
  sta TEXT_COUNTER+1                              // 
  lda #58                                         // 
  sta TEXT_COUNTER+2                              // 
dec2                                              // 
  dec TEXT_COUNTER+2                              // 
  dec TEMP_I                                      // 
  lda TEMP_I                                      // 
  cmp #0                                          // 
  bne wait_for_wifi                               // 
                                                  // 
exit_wait                                         // 
  lda #49                                         // 
  sta TEXT_COUNTER+1                              // 
  lda #48                                         // 
  sta TEXT_COUNTER+2                              // 
  displayText text_empty_line, #13,#0             // 
  displayText text_empty_line, #23,#0             //
  jsr get_status                                  // 
  jmp wifi_get_cred                               // 
                                                  // 
                                                  // 
                                                  // 
                                                  // 
                                                  // 
// ---------------------------------------------------------------------
// read a field and send it to the cartridge
// input row and column in TEMP_I and TEMP_I+1
// set length of textbox in TEXTBOXLEN
// ---------------------------------------------------------------------
read_field:                                       //
  lda SAVMSC                                      // 
  sta TEXTBOX                                     // 
  lda SAVMSC+1                                    // 
  sta TEXTBOX+1                                   //
  jsr open_field                                  // get a pointer to the start adres of the field
  ldy #0                                          // 
loopr                                             // 
  cpy TEXTBOXLEN                                  // compare y (our index) with the field length
  beq loopr_exit                                  // if we reach the end of the field, exit
  lda (TEXTBOX),y                                 // read the field with index y
  jsr wait_for_RTR                                // wait for ready to receive on the cartridge
  sta $D502                                       // write the data to the cartridge
  iny                                             // increase our index
  jmp loopr                                       // loop to read the next character
loopr_exit                                        // 
  jsr wait_for_RTR                                // after the field data has been send, we need
  lda #128                                        // to close the transmission with byte 128
  sta $D502                                       // send 128 to the cartridge
  rts                                             // return
// ---------------------------------------------------------------------
// Open a field to read                  
// input row and column in TEMP_I and TEMP_I+1               
// this procedure creates a pointer to the field in TEXTBOX (2 bytes)               //
// ---------------------------------------------------------------------
open_field:                                       // 
  ldx TEMP_I                                      // get the row (TEMP_I holds the row number)
sm_lineadd                                        // SAVMSC is the start of screen memory
  clc                                             // clear carry
  lda TEXTBOX                                     // start at the start of screen memory
  adc #40                                         // add 40 chars (one row)
  sta TEXTBOX                                     // store TEXTBOX (this is the low byte of the pointer)
  bcc sm_ld_done                                  // if carry is set (overflow), we need to increase the high byte
  inc TEXTBOX+1                                   // increase the high byte if needed
sm_ld_done                                        // one row added, done
  dex                                             // decrease x
  bne sm_lineadd                                  // repeat the above if x is not zero
                                                  // now we are on the right row, next skip to the right column
  ldx TEMP_I+1                                    // get the column
sm_rowadd                                         // 
  clc                                             // 
  lda TEXTBOX                                     // 
  adc #1                                          // add one..
  sta TEXTBOX                                     // if we overflow, increase the high byte also
  bcc sm_rd_done                                  // 
  inc TEXTBOX+1                                   // 
sm_rd_done                                        // 
  dex                                             // decrease x and repeat if needed
  bne sm_rowadd                                   // 
  rts                                             // return to sender, just like Elvis baby!
                                                  // 
//=========================================================================================================
//  Vice Simulation check
//=========================================================================================================
are_we_in_the_matrix:                             // 
  mva #0 VICEMODE                                 // this is to check if a real cartridge is attached
                                                  // or if we are running in the a simulator
                                                  // 
  jsr wait_for_RTR                                // 
  lda #245                                        // Load number #245 (to check if the esp32 is connected)
  sta $D502                                       // write the byte to IO1
                                                  // 
                                                  // Send the ROM version to the cartrdige
  ldx #0                                          // x will be our index when we loop over the version text
sendversion                                       // 
  jsr wait_for_RTR                                // wait for ready to receive (bit D7 goes high)
  lda VERSION,x                                   // load a byte from the version text with index x
                                                  // 
  sta $D502                                       // send it to IO1
  cmp #128                                        // if the last byte was 128, the buffer is finished
  beq check_matrix                                // exit in that case
  inx                                             // increase the x index
  jmp sendversion                                 // jump back to send the next byte
                                                  // 
check_matrix                                      // 
  lda #100                                        // Delay 100... hamsters
  sta DELAY                                       // Store 100 in the DELAY variable
  jsr jdelay                                      // and call the delay subroutine
  jsr wait_for_RTS                                // 
  lda $D502                                       // read from cartridge
  cmp #128                                        // 
                                                  // 
  beq exitSimCheck                                // if vice mode, we do not try to communicate with the
  lda #1                                          // cartridge because it will result in error
  sta VICEMODE                                    //  
  lda #100                                        // 
  sta CONFIG_STATUS                               // 
                                                  //
exitSimCheck                                      // 
  lda #100                                        // Delay 100... hamsters
  sta DELAY                                       // Store 100 in the DELAY variable
  jsr jdelay                                      // and call the delay subroutine
  rts                                             // 
                                                  // 
// ---------------------------------------------------------------------
// Send a command byte to the cartridge and wait for response//
// ---------------------------------------------------------------------
send_start_byte:                                  // 
  jsr wait_for_RTR                                // 
  sta $D502                                       // send the command byte
  ldx #0                                          // 
  lda $14                                         // 
  sta tempt                                       // save the status of the timer
  lda #200                                        // set a timeout
  sta $14                                         // $14 is one of the clocks
ff_response_loop                                  // now wait for a response
  jsr wait_for_RTS                                // 
  lda $D502                                       // 
  sta RXBUFFER,x                                  // 
  cmp #128                                        // 
  beq ff_end_buffer                               // 
  inx                                             // 
  lda $14                                         // 
  cmp #0                                          // 
  beq ssb_timeout                                 // 
  jmp ff_response_loop                            // 
                                                  // 
ff_end_buffer                                     // 
  inx                                             // 
  lda #128                                        // 
  sta RXBUFFER,x                                  // 
  lda tempt                                       // 
  sta $14                                         // 
  rts                                             // 
                                                  // 
ssb_timeout                                       // 
  lda #128                                        // we did get a response in time (byte 128 was not received)
  sta RXBUFFER                                    // 
  lda tempt                                       // 
  sta $14                                         // 
  rts                                             // 
// ----------------------------------------------------------------------
// Wait until the cartridge is ready to receive data (RTR)
// ----------------------------------------------------------------------

wait_for_RTR:                                     // 
  pha                                             // 
wait_for_RTR2                                     // 
  lda $D500                                       // check RTR
  and #%00000001                                  // 
  cmp #%00000001                                  // 
  bne wait_for_RTR2                               //     
  pla                                             //
  rts                                             // 
                                                  //
// ----------------------------------------------------------------------
// Wait until the cartridge is ready to send data (RTS)
// ----------------------------------------------------------------------
wait_for_RTS:                                     //                                
  pha
wait_for_RTS2 
  lda $D501                                       // check RTS
  and #%00000010                                  // 
  cmp #%00000010                                  // 
  bne wait_for_RTS2                               // 
  pla
  rts                                             
 
  
// ----------------------------------------------------------------------
// Check for messages
// ----------------------------------------------------------------------
check_for_messages:                               // 
  lda #0                                          // reset the ATTRAC byte, https://www.atariarchives.org/mmm/page_zero.php
  sta $004D                                       // to prevent the color change after 10 minutes or so..
  clc
  lda SCROLLMODE                                  // do not check for messages if we are in scroll mode
  adc MENU_ID                                     // do not check for messages if we are in a menu
  cmp #0                                          // 
  beq check_cont                                  // 
  jmp check_exit                                  // 
check_cont                                        // 
  lda $14                                         // 
  cmp #80                                         // 
  bcs check_cont2                                 // 
  jmp check_exit                                  // 
check_cont2                                       // 
  lda #0                                          // 
  sta $14                                         // 
  ldy #0                                          // 
                                                  // 
  lda VICEMODE                                    // 
  cmp #1                                          // 
  bne check_wifi                                  // 
  jmp check_exit                                  // 
check_wifi                                        // 
  lda WIFISTATUS                                  // 
  cmp #49                                         // 
  beq check_priv_or_pub                           // 
  jsr get_wifi_status                             // 
  lda WIFISTATUS                                  // 
  cmp #1                                          // 
  beq check_priv_or_pub                           // 
  jmp check_exit                                  // 
check_priv_or_pub                                 // 
  lda SCREEN_ID                                   // 
  cmp #3                                          // 
  bne check_is_publ                               // 
  lda #247                                        // 
  jmp check_ff                                    // 
check_is_publ                                     // 
  lda #254                                        // 
check_ff                                          // 
  jsr send_start_byte                             // RX buffer now contains a message or 128
  lda RXBUFFER                                    // 
  cmp #128                                        // 
  beq getNumberOfPrivateMessages                  // 
  jmp display_message                             // 
                                                  // 
getNumberOfPrivateMessages                        // 
  jsr checkForUpdates                             // first check for updates (new firmware)
  lda SCREEN_ID                                   // 
  cmp #3                                          // 
  beq check_exit                                  // 
  lda #241                                        // 
  jsr send_start_byte                             // 
  mva COLCRS savecc                               // 
  mva ROWCRS savecr                               // 
  lda #8                                          // set a length limit for the pm count
  sta LENLIMIT                                    //
  lda RXBUFFER                                    // 
  cmp #$5b                                        // compare, see if first character is [ 
  beq displayPMnumber                             // if not, show the normal divider line
  //displayBuffer NOPMS, #20,#30,#0                 // 
  displayText DIVIDER_LINE, #20,#0
  jmp check_exit0                                 // 
displayPMnumber                                   // display number of private messages
  displayBuffer RXBUFFER, #20,#30,#0              // 
check_exit0                                       // 
  mva savecc COLCRS                               // 
  mva savecr ROWCRS                               // 
  jsr show_cursor                                 // 
check_exit                                        // 
  rts                                             // 
                                                  // 
savex .byte 0                                     // 
savecr .byte 0                                    // 
savecc .byte 0                                    // 
display_message:                                  // the RXBUFFER contains a message.
  mva COLCRS savecc                               // 
  mva ROWCRS savecr                               // 
  ldx #0                                          // 
make_room_loop                                    // 
  lda RXBUFFER,x                                  // 
  cmp #1                                          // 
  bne get_display_start_address                   // 
  stx savex                                       // 
  jsr shift_screen_up                             // 
  ldx savex                                       // 
  inx                                             // 
  jmp make_room_loop                              // 
                                                  // 
get_display_start_address                         // 
                                                  // determine start address in screen memory
  mwa STARTLINE1 TEMP_I                           // 
  lda savex                                       // 
  cmp #0                                          // 
  beq do_display                                  // 
  mwa STARTLINE2 TEMP_I                           // 
  lda savex                                       // 
  cmp #1                                          // 
  beq do_display                                  // 
  mwa STARTLINE3 TEMP_I                           // 
  lda savex                                       // 
  cmp #2                                          // 
  beq do_display                                  // 
  mwa STARTLINE4 TEMP_I                           // 
                                                  // 
do_display                                        // 
                                                  // loop the RX buffer
  ldx savex                                       // 
  inx                                             // 
  ldy #0                                          // 
rxb_loop                                          // 
  lda RXBUFFER,x                                  // 
  cmp #128                                        // 
  beq get_m_exit                                  // 
  cmp #254                                        // we use this as inverted space in messaging
  bne write_char                                  // 
  lda #128                                        // this is a real inverted space
write_char                                        // 
  sta (TEMP_I),y                                  // 
  iny                                             // 
  inx                                             // 
  jmp rxb_loop                                    // 
                                                  // 
get_m_exit                                        // 
  jsr bell1                                       // 
  mva savecc COLCRS                               // 
  mva savecr ROWCRS                               // 
  mva #80 $14                                     // 
  rts                                             // 
                                                  // 
// ----------------------------------------------------------------------
// Check for updates
// ----------------------------------------------------------------------
checkForUpdates                                   // 
  lda NEWROM                                      // if we allready know there is a new version, skip the check
  cmp #128                                        // 
  bne exitVersions                                // 
  lda #239                                        // 
  jsr send_start_byte                             // 
  lda RXBUFFER                                    // if there is a new version, RXBUFFER contains the new version numbers
  cmp #128                                        // or it could contain nothing, just 128 if there is no new version
  bne getVersions                                 // 
  rts                                             // 
                                                  // 
                                                  // 
getVersions                                       // 
  ldy #0                                          // 
getRom                                            // 
  lda RXBUFFER,y                                  // 
  sta NEWROM,y                                    // 
  cmp #32                                         // 
  beq getVersionEsp                               // 
  iny                                             // 
  jmp getRom                                      // 
getVersionEsp                                     // 
  lda #128                                        // 
  sta NEWROM,y                                    // 
  ldx #0                                          // 
  iny                                             // 
getEsp                                            // 
  lda RXBUFFER,y                                  // 
  sta NEWESP,x                                    // 
  cmp #128                                        // 
  beq exitVersions                                // 
  iny                                             // 
  inx                                             // 
  jmp getEsp                                      // 
exitVersions:                                     // 
  rts                                             // 
                                                  // 
// ----------------------------------------------------------------------
// procedure for text input
// ----------------------------------------------------------------------
text_input:                                       // 
  mva #0 CURSORINH                                // show the cursor
key_loop                                          // 
  jsr blinkCursor                                 //
  jsr check_for_messages                          // 
klgk
  jsr getKey                                      // 
  cmp #255                                        // 
  beq key_loop                                    // 
cpoption                                          // 
  cmp #251                                        // ESC is pressed
  bne cp_scroll_up                                // 
  jsr handle_escape                               //
cp_scroll_up                                      // 
  cmp #139                                        // Control + u = scroll up 
  bne cp_scroll_down                              //
  jsr scroll_up                                   //
  jmp cpshortloop                                        //
cp_scroll_down                                    //
  cmp #186                                        // Control + d = scroll down  
  bne cpshortloop                                 //
  jsr scroll_down                                 //
  jmp cpshortloop                                        //
cpshortloop
  ldx SCROLLMODE
  cpx #1
  bne cpClear
  jmp key_loop  
                                                  //
cpClear                                           // 
  cmp #1                                          // 
  bne cpselect                                    // 
  jsr clear_input_lines                           // 
  mva #255 $2fc                                   // clear keyboard buffer
  jmp key_loop                                    // 
                                                  // 
                                                  // 
cpselect                                          // 
  cmp #252                                        // 
  bne cpstart                                     // 
  lda MENU_ID                                     // 
  cmp #13                                         // 
  beq jmp_reset_screen                            // 
  cmp #10                                         // 
  bcs key_loop                                    // 
  mva #255 $2fc                                   // clear keyboard buffer
  jmp toggle_screens                              // 
                                                  // 
jmp_reset_screen                                  // 
  jmp reset_screen                                // 
                                                  //
cpstart                                           // 
  cmp #253                                        // 
  bne cpdelete                                    // 
  lda MENU_ID                                     // 
  cmp #10                                         // 
  bcs key_loop                                    // 
  mva #255 $2fc                                   // clear keyboard buffer
start_send                                        //
  jsr check_private                               // check if users tries to send a private message
  jsr send_message                                // 
  mva #0 inhsend                                  // 
  lda doswitch                                    // 
  cmp #1                                          // 
  bne cpstart_exit                                // 
  mva #255 $2fc                                   // clear keyboard buffer
  jsr clear_input_lines                           // 
  mva #0 doswitch                                 // 
  jmp toggle_screens                              // 
cpstart_exit                                      // 
  jmp key_loop                                    // 
                                                  // 
cpdelete                                          // 
  cmp #8                                          // delete key is pressed
  bne cpreturn
  jmp handle_delete                               // 
                                                  // 
cpreturn                                          // 
  cmp #13                                         // 
  bne cp_up                                       // 
  jmp handle_return                               // 
                                                  // 
cp_up                                             // check the cursor keys up down left right
  cmp #142                                        // 
  bne cp_down                                     // 
  jmp handle_up                                   // 
cp_down                                           // 
  cmp #143                                        // 
  bne cp_left                                     // 
  jmp handle_down                                 // 
cp_left                                           // 
  cmp #134                                        // 
  bne cp_right                                    // 
  jmp handle_left                                 // 
cp_right                                          // 
  cmp #135                                        // 
  bne check_end_pos                               // 
  jmp handle_right                                // 
                                                  // 
check_end_pos                                     // 
  pha                                             // 
  lda ROWCRS                                      // 
  cmp #23                                         // 
  bne rp                                          // 
  lda COLCRS                                      // 
  cmp #39                                         // 
  bne rp                                          // 
  pla                                             // 
  lda #$1E                                        // 
  jmp chrout                                      // 
rp pla                                            // 
                                                  // 
chrout                                            // output the key to screen
  pha                                             // 
  lda MENU_ID                                     // 
  cmp #10                                         // 
  bcs in_field                                    // 
                                                  // 
out_ok                                            // 
  pla                                             // 
  jsr write_text                                  // 
out_exit                                          // 
  mva #255 $2fc                                   // clear keyboard buffer
  jmp key_loop                                    // 
in_field                                          // 
  lda COLCRS                                      // 
  cmp FIELD_MAX                                   // 
  bcc out_ok                                      // 
  pla                                             // 
  jsr write_text                                  // 
  lda #$1E                                        // 
  jsr write_text                                  // 
  jmp out_exit                                    // 
                                                  // 
handle_escape:
  mva #255 $2fc                                   // clear keyboard buffer  
  lda SCROLLMODE
  cmp #0
  beq esc_1
  lda #0
  sta SCROLLMODE
  sta FIRSTDOWN
  mva #0 MCURSORX                                 // restore the cursor position
  mva #21 MCURSORY                                // restore the cursor position
  jmp restore_screen
  
  
esc_1
  jsr backup_screen                               // 
  jmp main_menu                                   // 

handle_delete                                     // 
                                                  // 
  lda MENU_ID                                     // 
  cmp #10                                         // 
  bcs del_in_field                                // 
hd_ok                                             // 
  lda ROWCRS                                      // 
  cmp #21                                         // 
  bne delok                                       // 
  lda COLCRS                                      // 
  cmp #0                                          // 
  bne delok                                       // 
  mva #255 $2fc                                   // clear keyboard buffer
  jmp key_loop                                    // 
delok                                             // 
                                                  // 
  lda #$1E                                        // this is to work around a bug. backspace does not always work
  jsr write_text                                  // when the cursor is at column zero.. this works around that
  lda COLCRS                                      // in stead of using backspace, we walk the cursor back,
  cmp #39                                         // write a space character and walk the cursor back again
  bne delcont                                     // But if you walk the cursor back on column zero, it goes
  lda #$1C                                        // to column 39 on that SAME LINE.. so we have to correct
  jsr write_text                                  // that too..
delcont                                           // Man this is getting ugly..
  lda #32                                         // 
  jsr write_text                                  // anyway, it works now. get over it, move on, have a beer
  lda #$1E                                        // 
  jsr write_text                                  // 
  lda COLCRS                                      // 
  cmp #39                                         // 
  bne delexit                                     // 
  lda #$1C                                        // 
  jsr write_text                                  // 
delexit                                           // 
  mva #255 $2fc                                   // 
  jmp key_loop                                    // 
                                                  // 
del_in_field                                      // 
  lda COLCRS                                      // 
  cmp FIELD_MIN                                   // 
  bcc delexit                                     // 
  lda #$7E                                        // 
  jsr write_text                                  // 
  jmp delexit                                     // 
                                                  // 
                                                  // 
handle_return                                     // 
  lda MENU_ID                                     // 
  cmp #10                                         // 
  bcs exit_on_return                              // 
  lda ROWCRS                                      // ignore this key if we are on the last line
  cmp #23                                         // 
  beq handle_return_send                          // 
  lda #$9b                                        // 
  jmp chrout                                      // 
exit_on_return                                    // 
  rts                                             // 
                                                  // 
handle_return_send                                // 
  mva #255 $2fc                                   // 
  jmp start_send                                  // 
  jmp key_loop                                    // 
                                                  // 
handle_up                                         // 
  lda MENU_ID                                     // 
  cmp #10                                         // 
  bcs up_exit                                     // 
  lda ROWCRS                                      // ignore this key if we are on the first line
  cmp #21                                         // 
  bne upok                                        // 
up_exit                                           // 
  mva #255 $2fc                                   // clear keyboard buffer
  jmp key_loop                                    // 
upok                                              // 
  lda #$1C                                        // 
  jmp chrout                                      // 
                                                  // 
handle_down                                       // 
  lda MENU_ID                                     // 
  cmp #10                                         // 
  bcs up_exit                                     // 
  lda ROWCRS                                      // ignore this key if we are on the last line
  cmp #23                                         // 
  bne downok                                      // 
  mva #255 $2fc                                   // clear keyboard buffer
  jmp key_loop                                    // 
downok                                            // 
  lda #$1D                                        // 
  jmp chrout                                      // 
                                                  // 
handle_left                                       // 
  lda MENU_ID                                     // 
  cmp #10                                         // 
  bcs lf_limit                                    // 
hl_ok                                             // 
  lda #$1E                                        // 
  jmp chrout                                      // 
lf_limit                                          // 
  lda COLCRS                                      // 
  cmp FIELD_MIN                                   // 
  bcs hl_ok                                       // 
  jmp hr_ng                                       // 
                                                  // 
handle_right                                      // 
  lda MENU_ID                                     // 
  cmp #10                                         // 
  bcs rf_limit                                    // 
hr_ok                                             // 
  lda #$1F                                        // 
  jmp chrout                                      // 
rf_limit                                          // 
  lda COLCRS                                      // 
  cmp FIELD_MAX                                   // 
  bcc hr_ok                                       // 
hr_ng                                             // 
  mva #255 $2fc                                   // clear keyboard buffer
  jmp key_loop                                    // 
                                                  // 
// ----------------------------------------------------------------------                                                  
// Scroll up and down reoutines.
// ----------------------------------------------------------------------                                                  
drawScrollInstructions:
  jsr clear_input_lines
  displayText DIVIDER_LINE, #20,#0
  displayText text_scrolling_mode, #21,#0
  rts
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
