bvenneker/AtariXL/(commit log)

2024-12-05 kicad updates
    [Cartridge_800xl_2.kicad_pcb, Cartridge_800xl_2.kicad_sch]
2024-12-06 debug user list issue
    [800XL_Chat_3_77.ino, wifi_core.h, wifi_core.ino]
2024-12-08 version 3
    No more sub version in file name
    Fixed the userlist issue
    [Cartridge_800xl_2.kicad_pcb, Cartridge_800xl_2.kicad_sch]
2024-12-08 bug fix
    you should not be able to submit an empty message
    [800XL_Chat_3.ino, Chat800XL_v3_0.asm, prgfile.h, wifi_core.ino]
2024-12-10 timout in receive
    prevent an endless loop with a timeout
    [800XL_Chat_3.ino, Chat800XL_v3_0.asm, prgfile.h]
2024-12-19 3.78 release
    [Cartridge_800xl_2.kicad_pcb]
2024-12-20 kicad update
    [Cartridge_800xl_2.kicad_pcb]
2024-12-27 send message fix
    very small bug when sending a private message from the public screen (whicg you should not do anyway):
    - pressing start to send the message worked fine
    - pressing shift return or control return worked fine
    - But pressing enter on the third line did not work.
    this is fixed now
    [Chat800XL_v3_0.asm, prgfile.h]
2025-01-11 Fixed some bugs and added a blinking cursor
    Fixed some situations where the Atari would hang
    Added a blinking cursor (so you can also clearly see if it hangs)
    [800XL_Chat_3.ino, Chat800XL_v3_0.asm, prgfile.h, wifi_core.ino]
2025-01-23 small update
    fixed a small bug with the blinking cursor
    [800XL_Chat_3.ino, Chat800XL_v3_0.asm, prgfile.h]
2025-01-31 small update
    sometimes, hearts would show up on the divider line.. that should be fixed now
    [800XL_Chat_3.ino, Chat800XL_v3_0.asm, prgfile.h]
2025-03-05 pcb update
    [Cartridge_800xl_2.kicad_pcb, Cartridge_800xl_2.kicad_sch]
2025-08-03 small changes
    [Cartridge_800xl_2.kicad_pcb]
